gisellegk/ECEN2440-final-project/Code/altimeter_teensy/Flight_Electronics_CPU/Altimeter_out.PNG

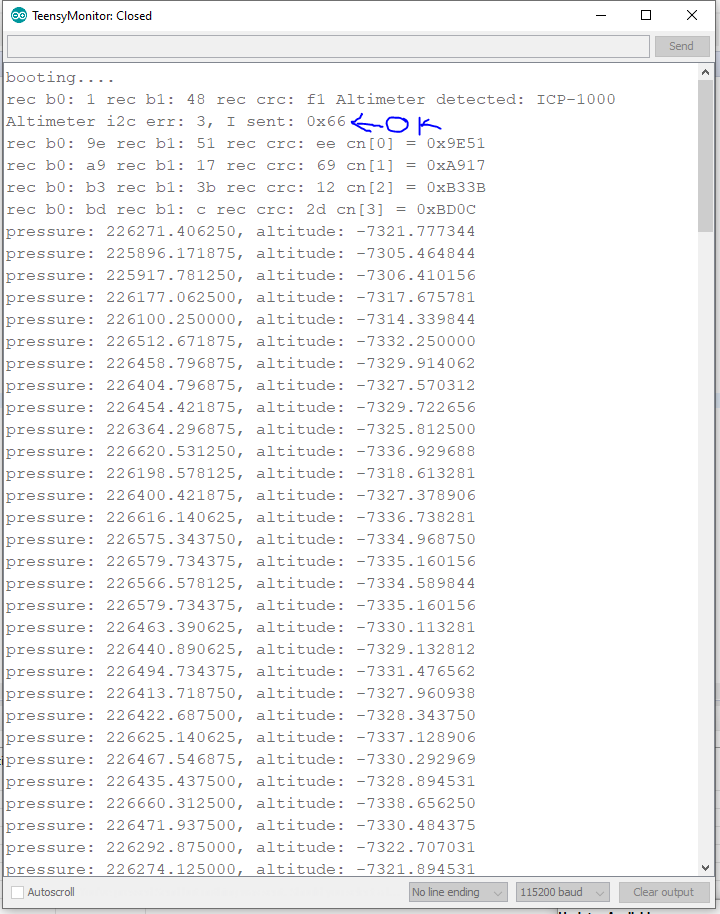
Code/altimeter_teensy/Flight_Electronics_CPU/Altimeter_out.PNG
