gisellegk/ECEN2440-final-project/ltspice/AZ2085/AZ2085 Voltage Range Simulation - 3 cell.PNG

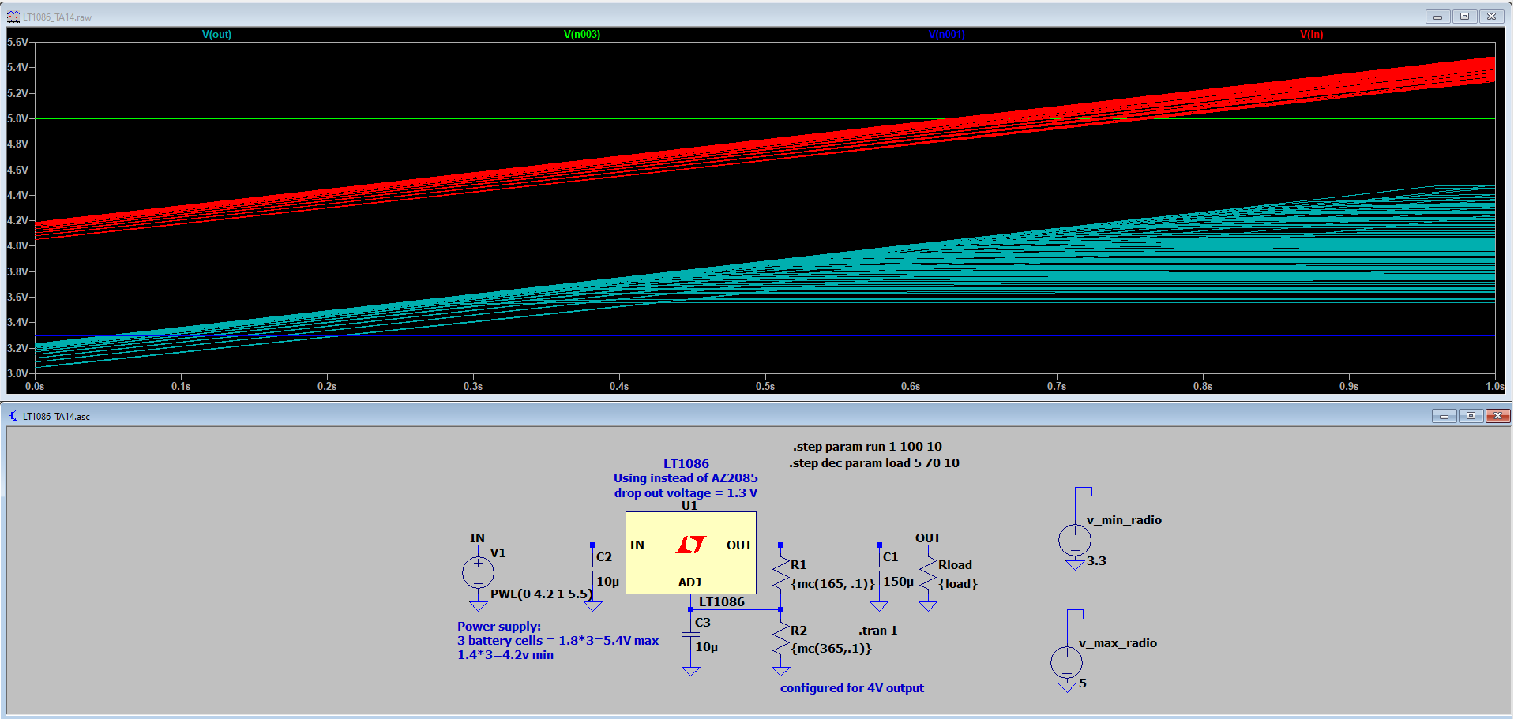
ltspice/AZ2085/AZ2085 Voltage Range Simulation - 3 cell.PNG
