gisellegk/ECEN2440-final-project/ltspice/AZ2085/AZ2085 Voltage Range Simulation - 4 cell.PNG

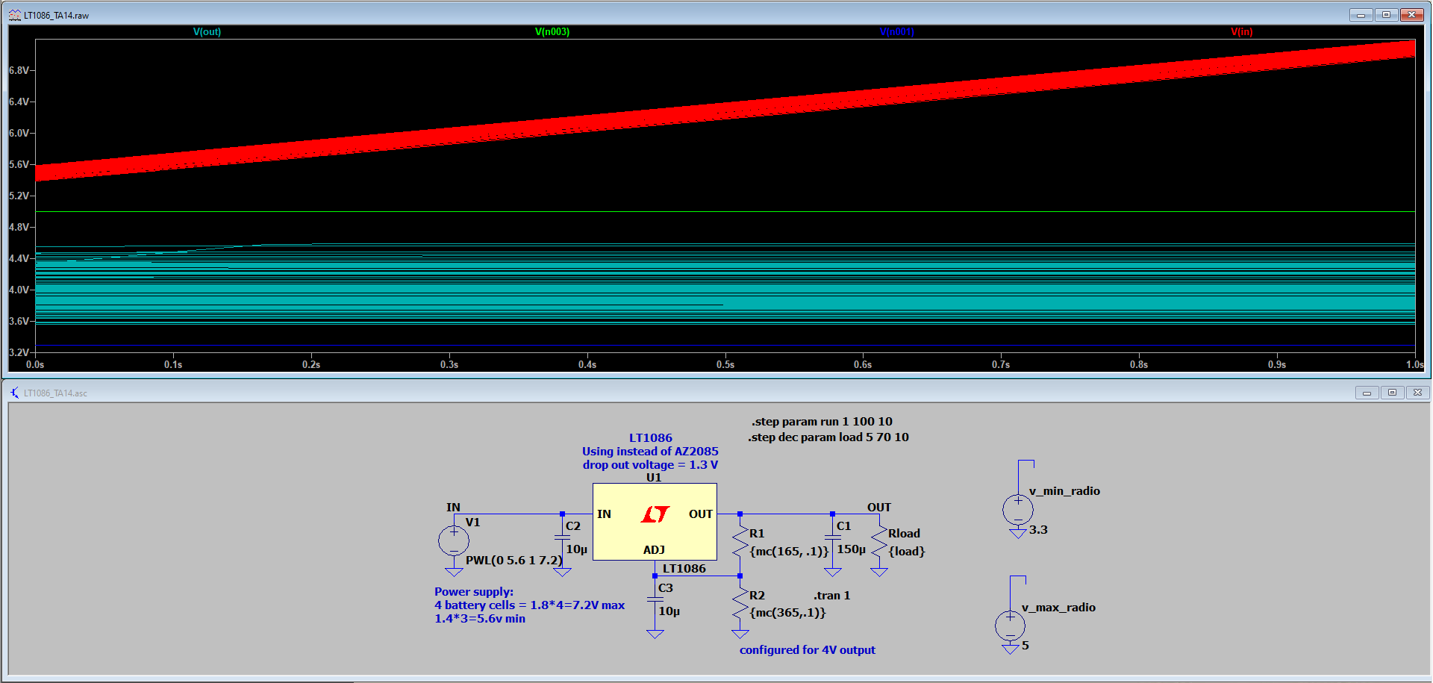
ltspice/AZ2085/AZ2085 Voltage Range Simulation - 4 cell.PNG
