gisellegk/ECEN2440-final-project/ltspice/export graph/FFT_2ord_100kHz.PNG

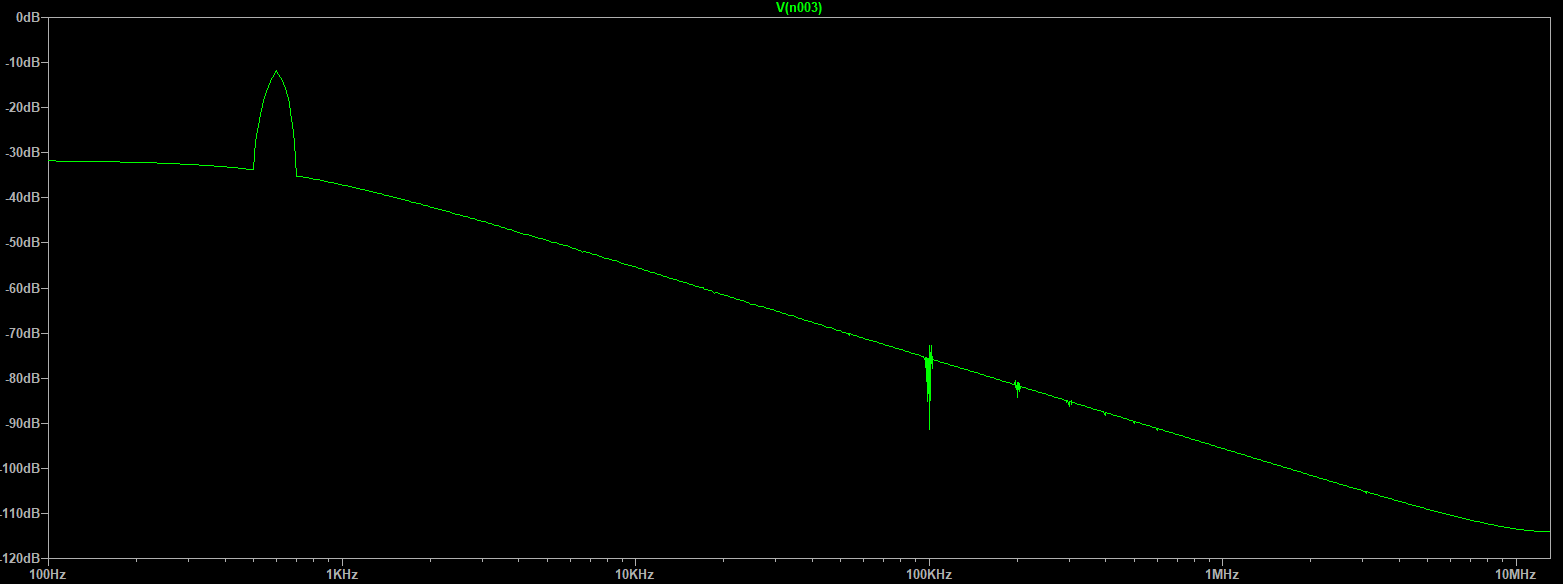
ltspice/export graph/FFT_2ord_100kHz.PNG
