gisellegk/ECEN2440-final-project/ltspice/export graph/FFT_3ord_100k200k_zoom.PNG

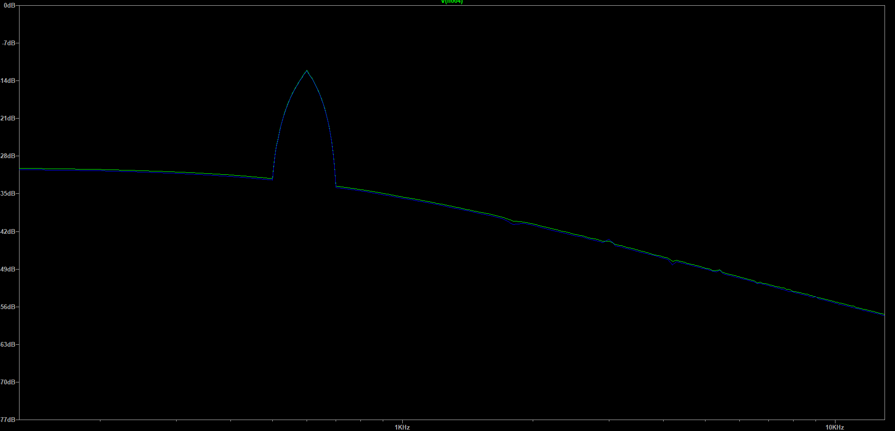
ltspice/export graph/FFT_3ord_100k200k_zoom.PNG
