gisellegk/ECEN2440-final-project/ltspice/export graph/FFT_3ord_300kHz.PNG

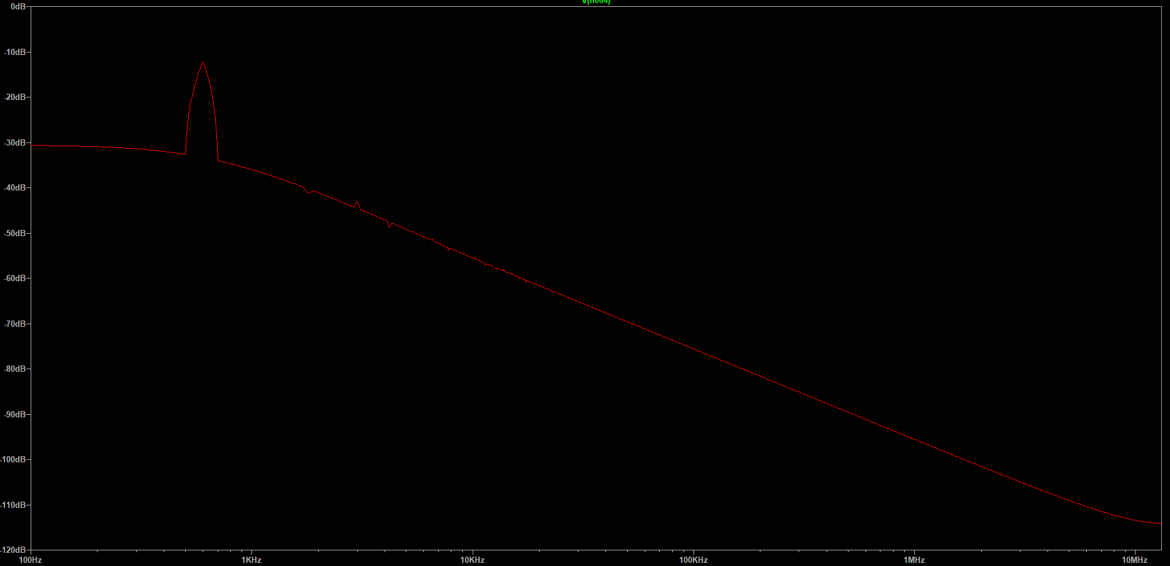
ltspice/export graph/FFT_3ord_300kHz.PNG
