gisellegk/ECEN2440-final-project/ltspice/export graph/SINE_2ord_100k200k300k500k.PNG

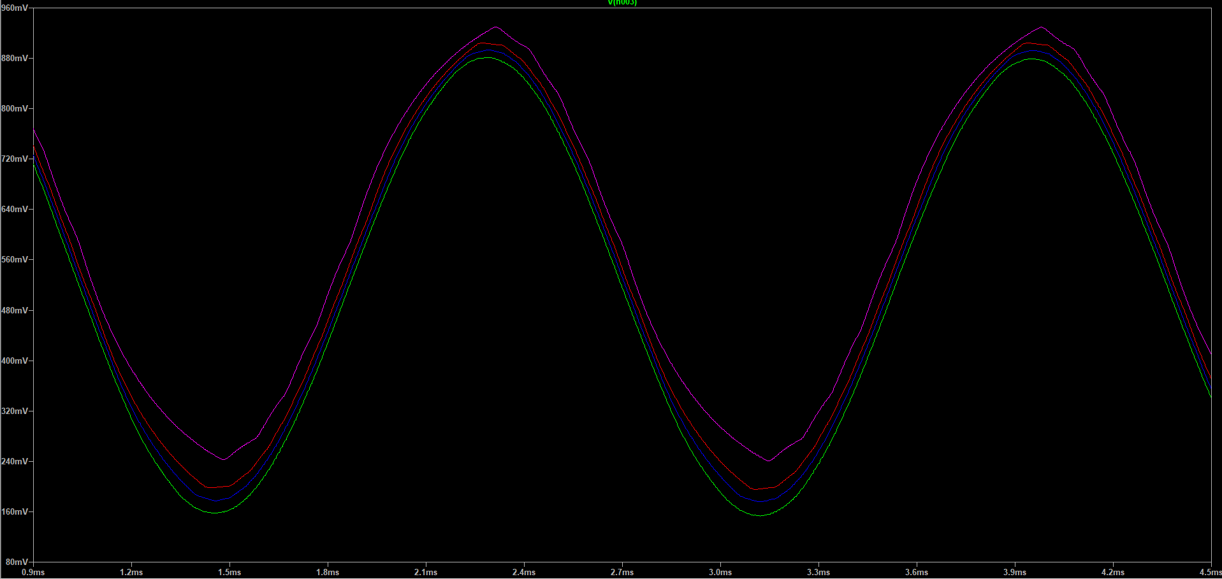
ltspice/export graph/SINE_2ord_100k200k300k500k.PNG
