gisellegk/ECEN2440-final-project/ltspice/LT1963A/LT1963 voltage output simulation.PNG

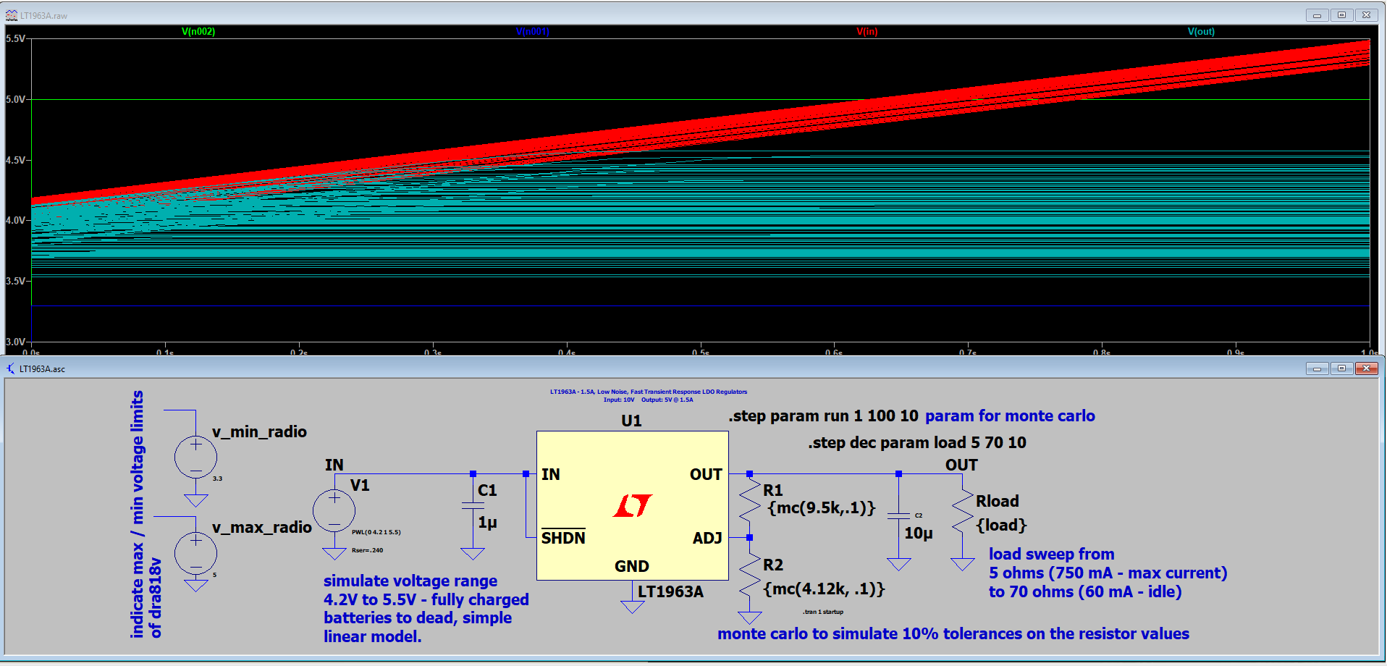
ltspice/LT1963A/LT1963 voltage output simulation.PNG
