gisellegk/ECEN2440-final-project/PCB/Altimeter Board/Bot.png

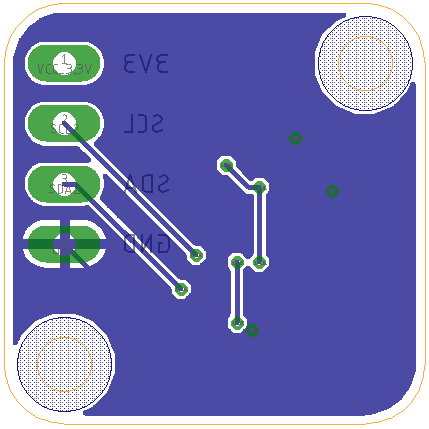
PCB/Altimeter Board/Bot.png
