gisellegk/ECEN2440-final-project/PCB/Altimeter Board/Top.png

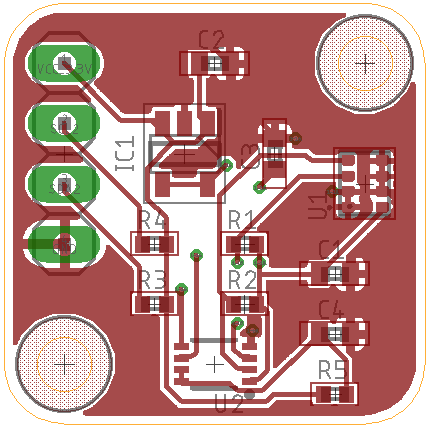
PCB/Altimeter Board/Top.png
