gisellegk/ECEN2440-final-project/PCB/ECEN 2440 Final Project/PDR SCHEMATIC.png

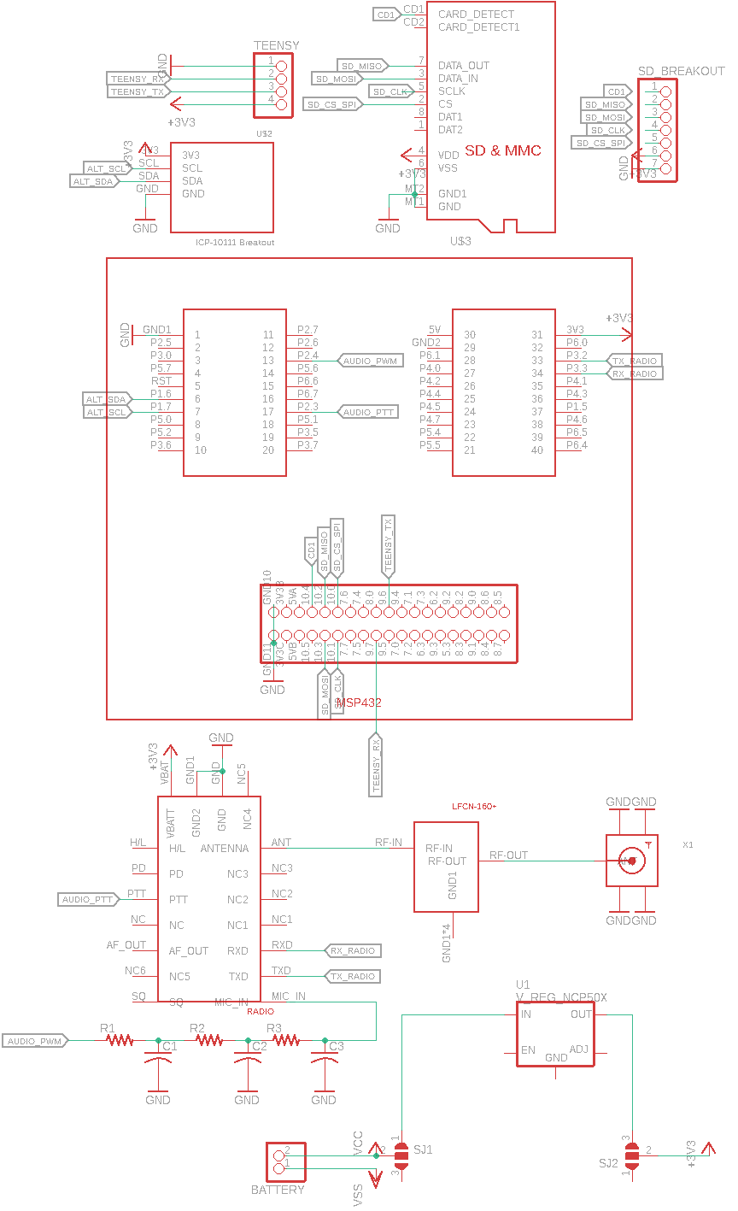
PCB/ECEN 2440 Final Project/PDR SCHEMATIC.png
