gisellegk/ECEN2440-final-project/PCB/ECEN 2440 Final Project/RF_both.PNG

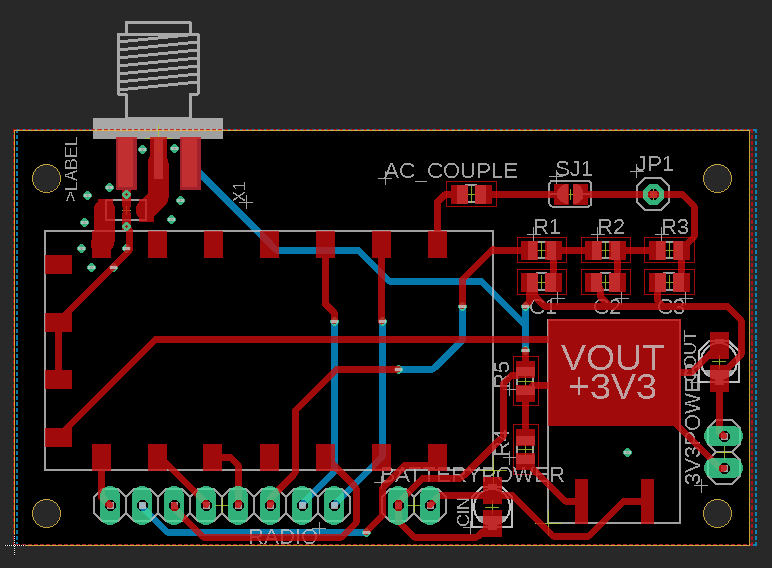
PCB/ECEN 2440 Final Project/RF_both.PNG
