gisellegk/ECEN2440-final-project/PCB/ECEN 2440 Final Project/RF_top.PNG

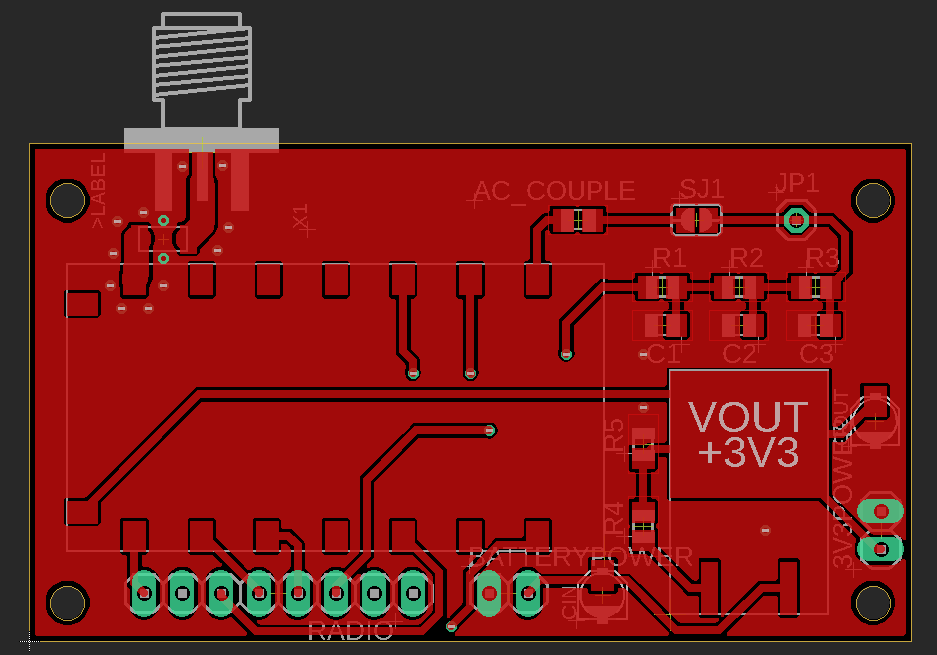
PCB/ECEN 2440 Final Project/RF_top.PNG
