gisellegk/ECEN2440-final-project/PCB/meowth/52-528157_meowth-meow-pokemon.png

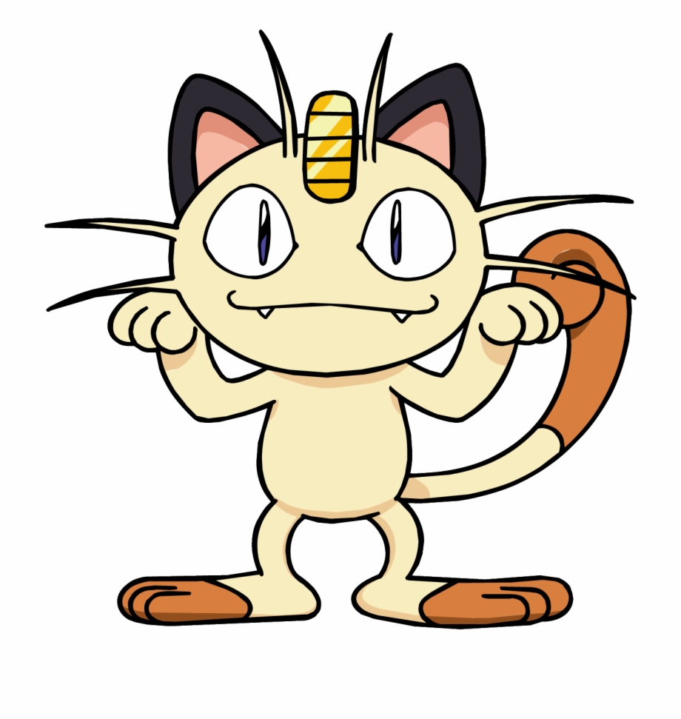
PCB/meowth/52-528157_meowth-meow-pokemon.png
