gisellegk/ECEN2440-final-project/PCB/meowth/meowth/meowth_oshpark_preview.PNG

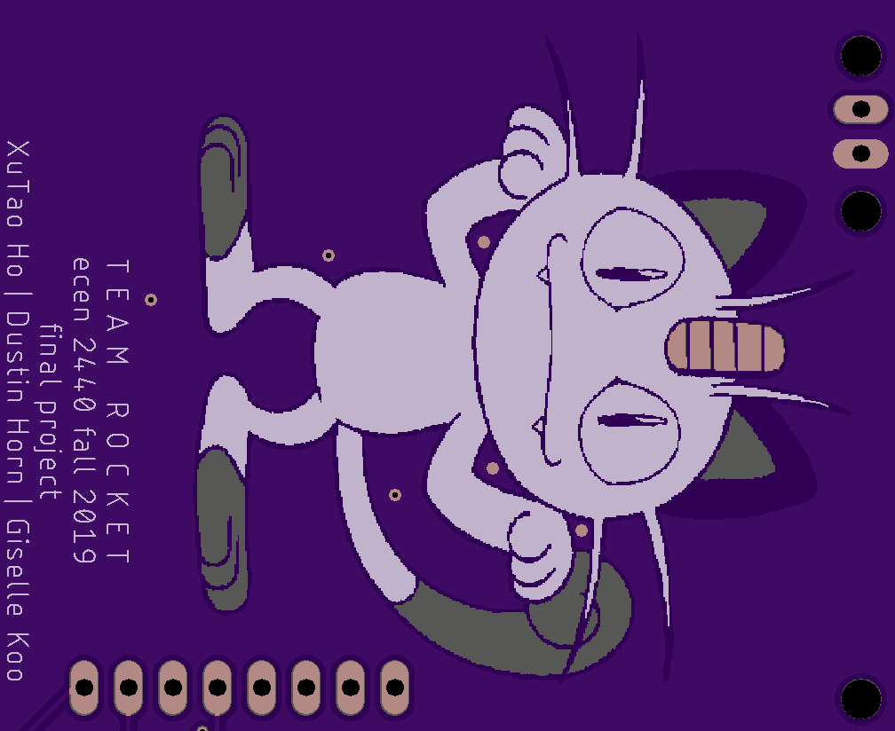
PCB/meowth/meowth/meowth_oshpark_preview.PNG
