gisellegk/ECEN2440-final-project/PCB/meowth/meowth/no_copper.bmp

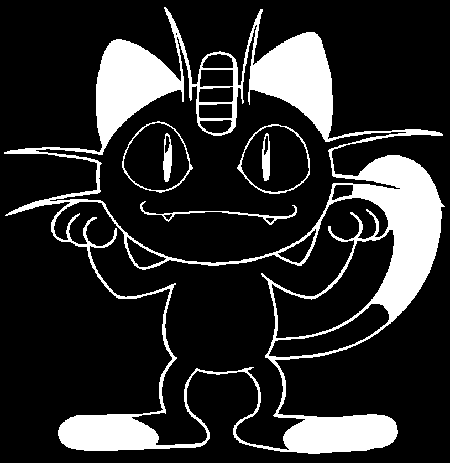
PCB/meowth/meowth/no_copper.bmp
