gisellegk/ECEN2440-final-project/PCB/meowth/meowth/silkscreen.bmp

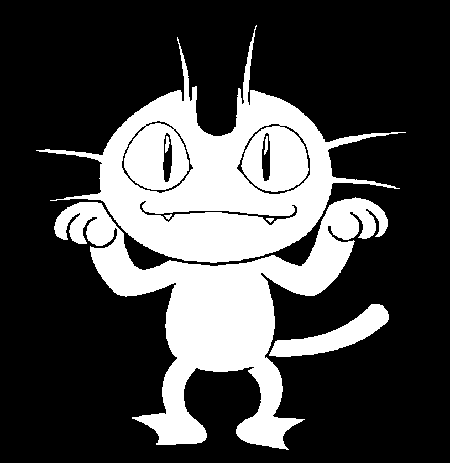
PCB/meowth/meowth/silkscreen.bmp
