gisellegk/ECEN2440-final-project/PCB/meowth/meowth_bold/meowth_bold_bw_copper.bmp

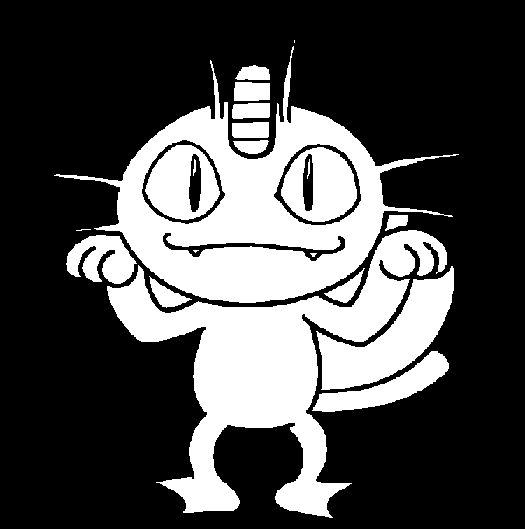
PCB/meowth/meowth_bold/meowth_bold_bw_copper.bmp
