gisellegk/ECEN2440-final-project/PCB/PCBWay Board Quote.PNG

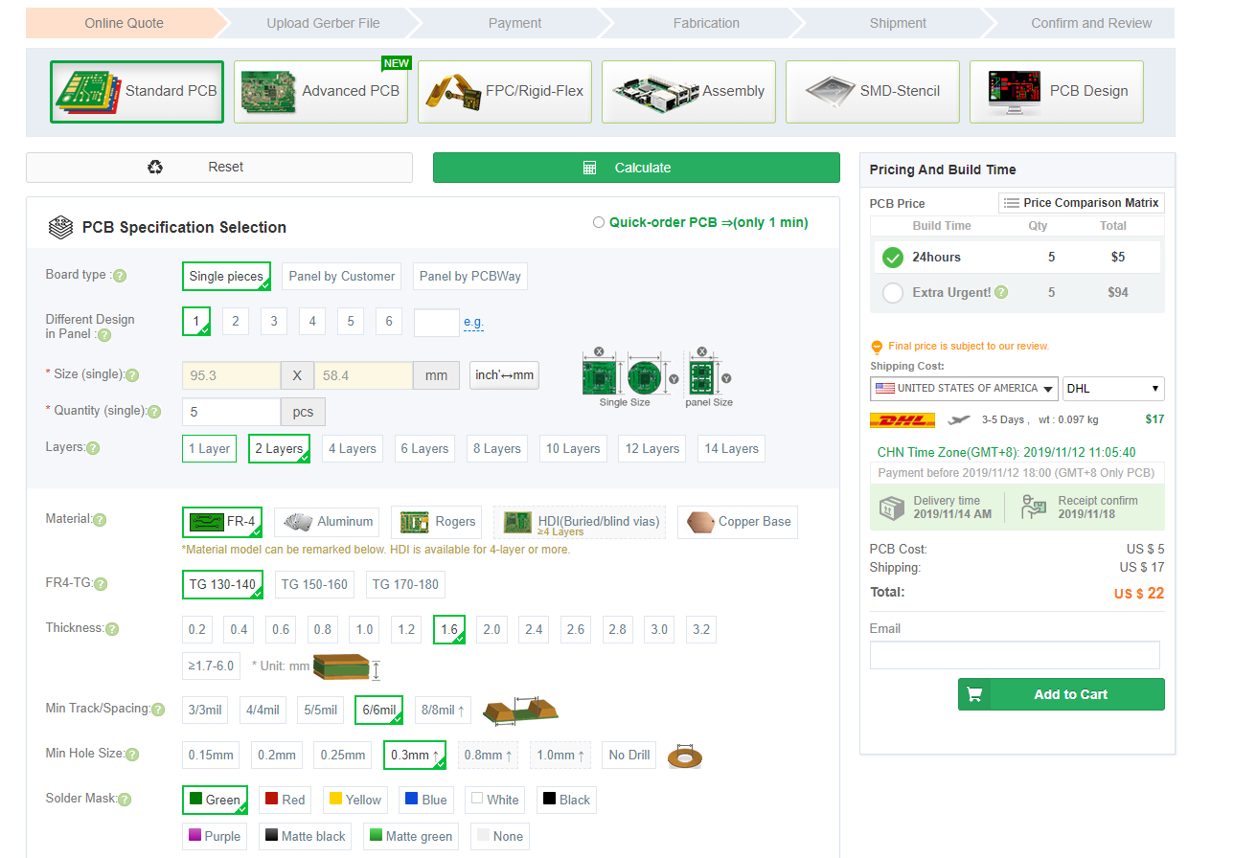
PCB/PCBWay Board Quote.PNG
