gisellegk/ECEN2440-final-project/PCB/wobbuffet/202.png

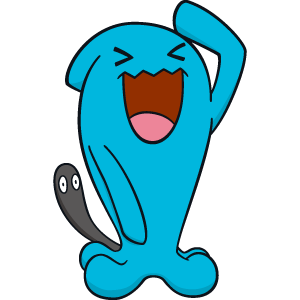
PCB/wobbuffet/202.png
