gisellegk/ECEN2440-final-project/PCB/wobbuffet/wob.bmp

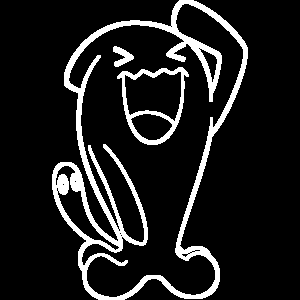
PCB/wobbuffet/wob.bmp
