gisellegk/ECEN2440-final-project/Housing/Prototype assembly.SLDASM

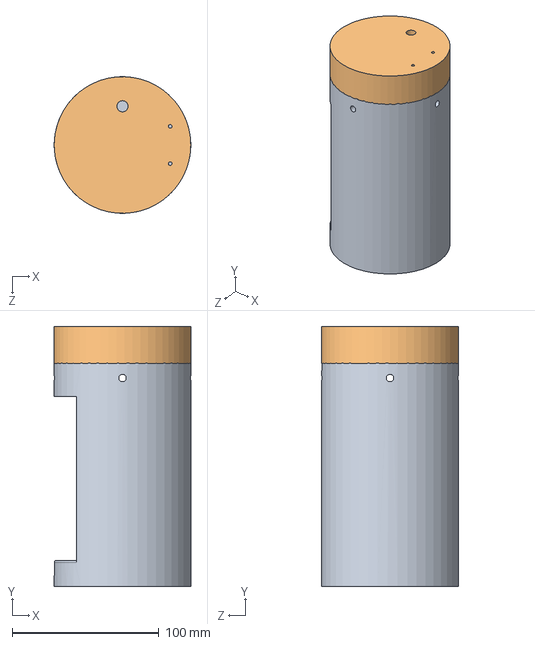
[picture p34: CAD file, 2019-12-04]
Housing/Prototype assembly.SLDASM
93.2 x 177.4 x 93.2 mm
Designed for tube prototype 2
Designed for tube prototype 2b
