gisellegk/ECEN2440-final-project/Housing/Prototype 1 assembly.SLDASM

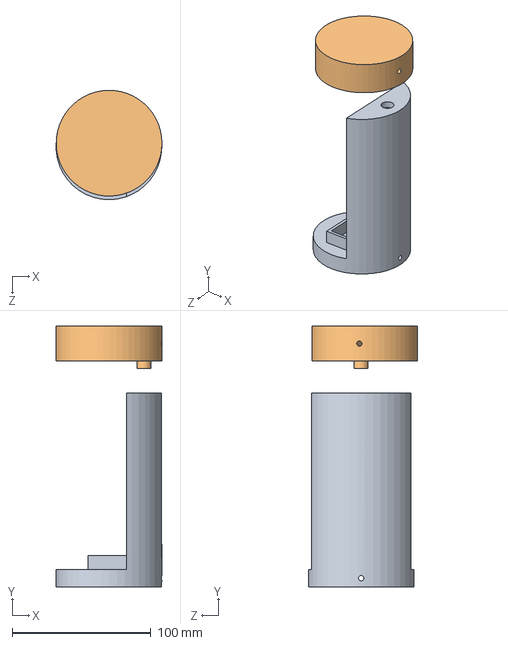
[picture p35: CAD file, 2019-11-29]
Housing/Prototype 1 assembly.SLDASM
76.3 x 188.1 x 78.8 mm
Prototype 1
prototype 1b
