gisellegk/ECEN2440-final-project/Housing/Designed for tube prototype 2b CAP THIS ONE.STL

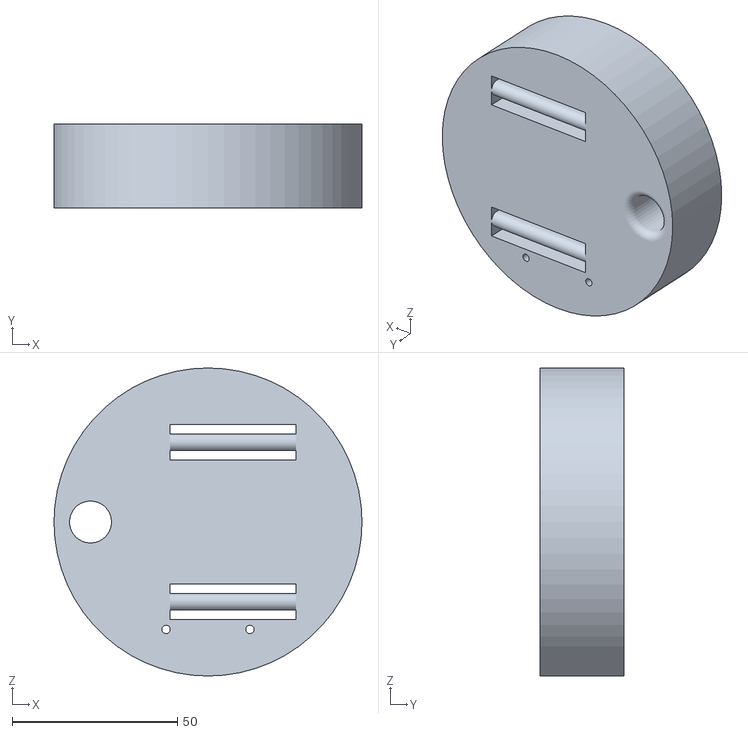
[picture p36: CAD file, 2019-12-07]
Housing/Designed for tube prototype 2b CAP THIS ONE.STL
93.2 x 25.4 x 93.2
