gisellegk/ECEN2440-final-project/Housing/Designed for tube prototype 2b.SLDPRT

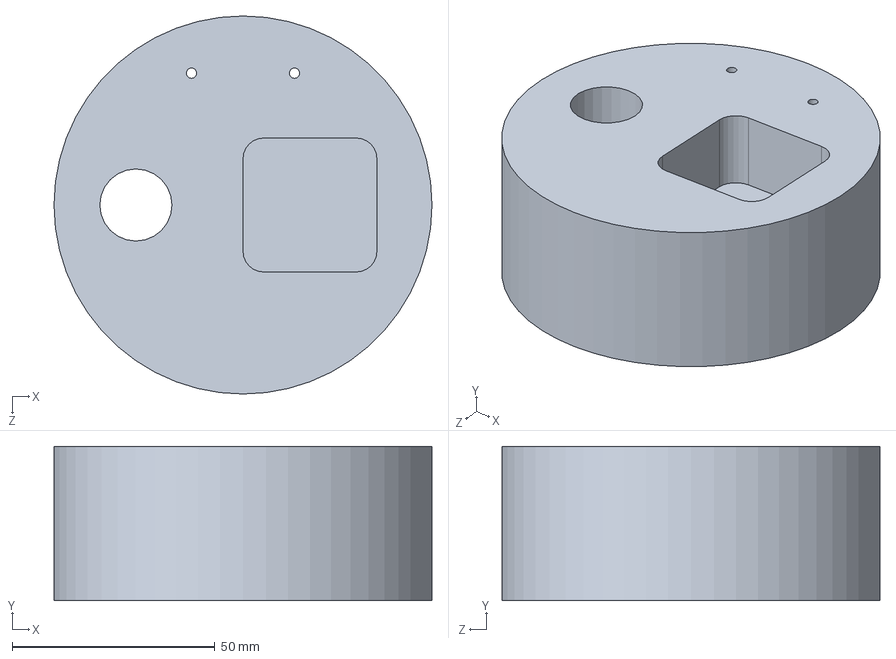
[picture p37: CAD file, 2019-12-06]
Housing/Designed for tube prototype 2b.SLDPRT
93.2 x 38.1 x 93.2 mm
