gisellegk/ECEN2440-final-project/Housing/Designed for tube prototype 2.SLDPRT

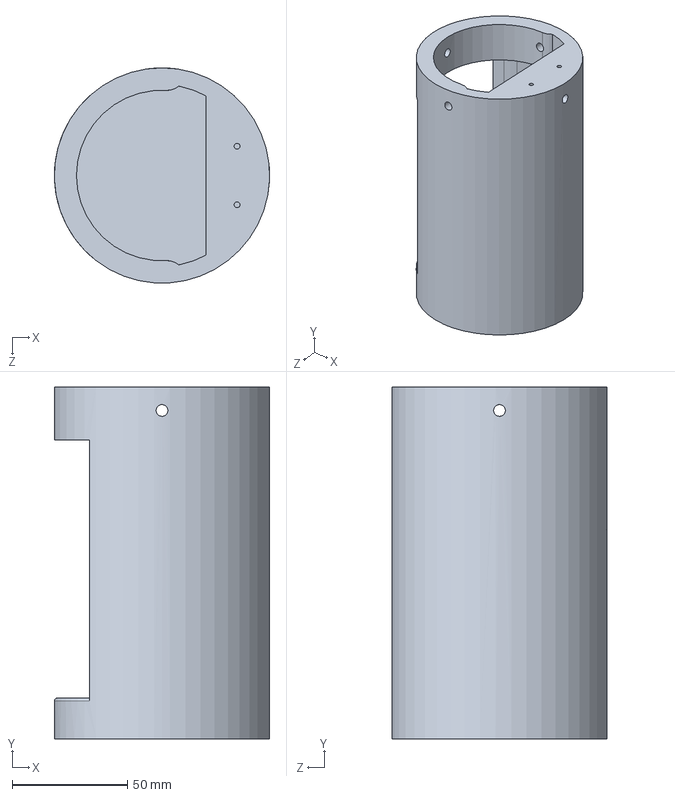
[picture p38: CAD file, 2019-12-05]
Housing/Designed for tube prototype 2.SLDPRT
93.2 x 152.4 x 93.2 mm
