gisellegk/ECEN2440-final-project/Housing/prototype 1b.SLDPRT

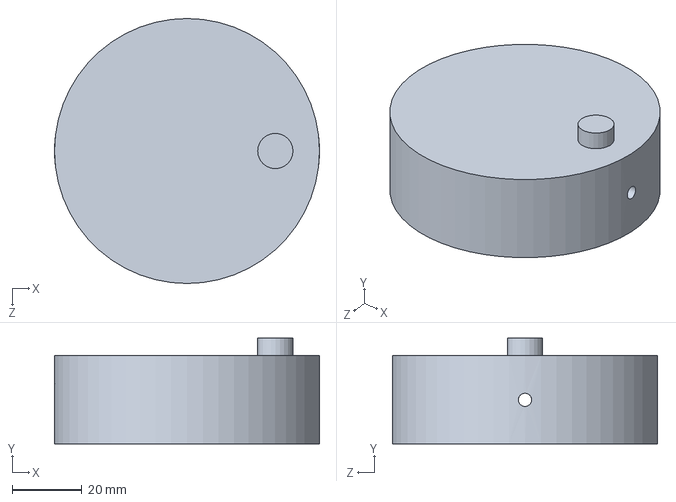
[picture p39: CAD file, 2019-11-29]
Housing/prototype 1b.SLDPRT
76.2 x 30.5 x 76.2 mm
