gisellegk/ECEN2440-final-project/Housing/Prototype 1.SLDPRT

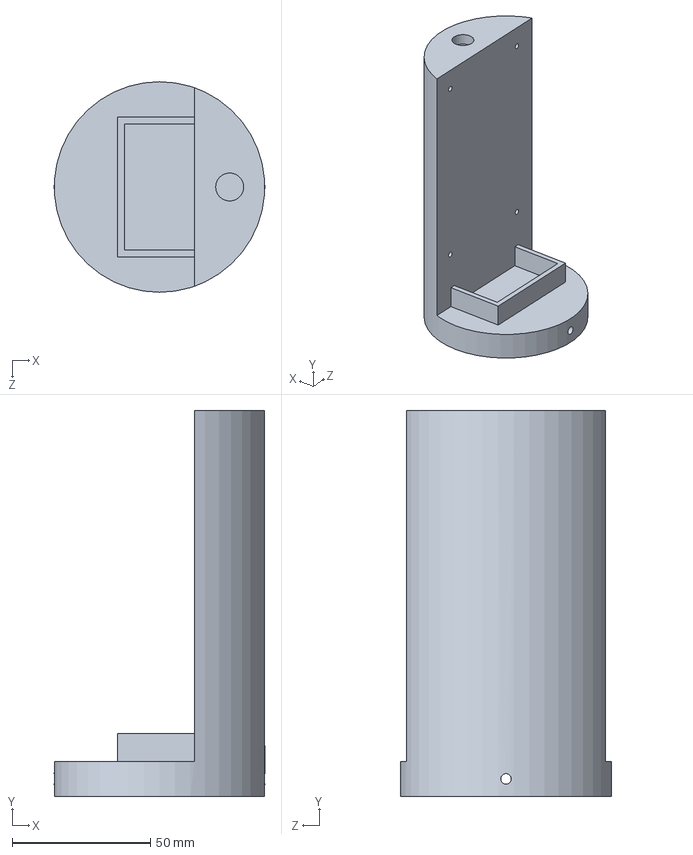
[picture p40: CAD file, 2019-11-29]
Housing/Prototype 1.SLDPRT
76.2 x 139.7 x 76.2 mm
