gisellegk/ECEN2440-final-project/(list of files, cad)

Other CAD files:
Housing/Designed for tube prototype 2.STL
