gisellegk/ECEN2440-final-project/PCB/meowth/meowth/no_soldermask.bmp

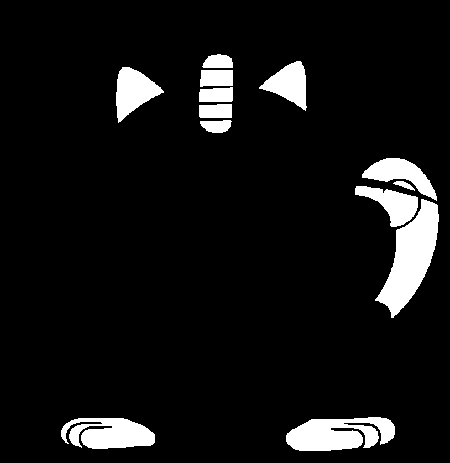
PCB/meowth/meowth/no_soldermask.bmp
