gisellegk/ECEN2440-final-project/pspice/BDxxC0AxFP/BDxxC0AxFP/TestCircuit/BD00C0AWFP-PSpiceFiles/1_CircuitCurrent/1_CircuitCurrent/1_CircuitCurrent.cir

** Profile: "1_CircuitCurrent-1_CircuitCurrent"  [ D:\1_WebUp\kakuninn\BD00C0A\TestCircuit\bd00c0awfp-pspicefiles\1_circuitcurrent\1_circuitcurrent.sim ] 

** Creating circuit file "1_CircuitCurrent.cir" 
** WARNING: THIS AUTOMATICALLY GENERATED FILE MAY BE OVERWRITTEN BY SUBSEQUENT SIMULATIONS

*Libraries: 
* Profile Libraries :
* Local Libraries :
.LIB "../../../bdxxc0axfp.lib" 
* From [PSPICE NETLIST] section of C:\SPB_Data\cdssetup\OrCAD_PSpice\17.2.0\PSpice.ini file:

*Analysis directives: 
.DC LIN V_VCC 0 26.5 0.01 
.OPTIONS ADVCONV
.PROBE64 V(alias(*)) I(alias(*)) W(alias(*)) D(alias(*)) NOISE(alias(*)) 
.INC "..\1_CircuitCurrent.net" 


.END
