gisellegk/ECEN2440-final-project/ltspice/LM317/Draft2.asc

C1: cap; {mc(2.2µ,.2)}; Rser={mc(100m,1)}
C4: cap; {mc(100n,.2)}; Rser={mc(100m,1)}
C5: cap; {mc(2.2µ,.2)}; Rser={mc(100m,1)}
COUT: cap; {mc(10µ,.2)}; Rser={mc(21,1)}
L1: ind; {mc(1.59µ, .3)}; Ipk=2 Rser={mc(100m,1)}
R1: res; {mc(2,.1)}
R8: res; {mc(2,.1)}
V1: voltage; SINE(4 1 144kHz); AC 1; Rser={mc(100m,1)}
Named nets: 0
.ac dec 100 1k 432Meg
mc on ESR of L:
mc(100m, 1)
mc on ESR of COUT:
mc(21, 1)
mc on ESR of C5:
mc(100m, 1)
mc on ESR of C4:
mc(100m, 1)
.step param run 1 100 1
