gisellegk/ECEN2440-final-project/ltspice/LM317/Draft1.asc

R1: res; {mc(120,.1)}
R2: res; {mc(240,.1)}
R3: res; {LOAD}
U1: LM317
V1: voltage; 5; Rser=240m
v_max_radio1: voltage; 5
v_min_radio1: voltage; 3.3
Named nets: 0, Vin, Vout
.dc V1 4.2 5.4 .01
.step param run 1 100 10
.step dec param LOAD 5 70 2
indicate max / min voltage limits
of dra818v
