gisellegk/ECEN2440-final-project/ltspice/AZ2085/LT1086_TA14.asc

C1: cap; 150µ
C2: cap; 10µ
C3: cap; 10µ
R1: RES; {mc(165, .1)}
R2: RES; {mc(365,.1)}
Rload: RES; {load}
U1: LT1086
V1: VOLTAGE; PWL(0 4.2 1 5.5); Rser=0.240
v_max_radio: VOLTAGE; 5; Rser=0.1
v_min_radio: VOLTAGE; 3.3; Rser=0.1
Named nets: OUT, 0, IN
.tran 1
LT1086
Using instead of AZ2085
drop out voltage = 1.3 V
configured for 4V output
Power supply: 
3 battery cells = 1.8*3=5.4V max
1.4*3=4.2v min
.step dec param load 5 70 10
.step param run 1 100 10
