gisellegk/ECEN2440-final-project/ltspice/LT1963A/LT1963A.asc

C1: cap; 1µ
C2: cap; 10µ
R1: res; {mc(9.5k,.1)}
R2: res; {mc(4.12k, .1)}
Rload: res; {load}
U1: LT1963A
V1: voltage; PWL(0 4.2 1 5.5); Rser=.240
v_max_radio: voltage; 5
v_min_radio: voltage; 3.3
Named nets: 0, OUT, IN
.tran 1 startup
LT1963A - 1.5A, Low Noise, Fast Transient Response LDO Regulators
Input: 10V     Output: 5V @ 1.5A
.step param run 1 100 10
.step dec param load 5 70 10
monte carlo to simulate 10% tolerances on the resistor values
load sweep from 
5 ohms (750 mA - max current) 
to 70 ohms (60 mA - idle)
simulate voltage range 
4.2V to 5.5V - fully charged 
batteries to dead, simple
linear model.
indicate max / min voltage limits
of dra818v
param for monte carlo
