gisellegk/ECEN2440-final-project/ltspice/PWM and Filtering/Draft2.asc

B1: bv; V=(V(TA_R)<=V(sine_LUT))
B2: bv; V=(idtmod(1,0,1/f_pwm)*Fsys)
B3: bv; V=(floor(V(Timer_Raw)))
B4: bv; V=floor(CR0*V(audio_sine))
C1: cap; {C}
C2: cap; {C}
C3: cap; {C}
R1: res; {R}
R2: res; {R}
R3: res; {R}
V2: voltage; SINE(.5 .5 600 0)
Named nets: 0, audio_sine, Timer_RAW, TA_R, sine_LUT
.step param f_pwm 100k 500k 100k
.tran 0 10m 0 10n
.param C 500n
.param R 100
.param Fsys 3e6
.param CR0 {Fsys/f_pwm}
600Hz desired audio 
voltage %, from 0 to 1
multiplying sine voltage % by 
CR0 (which is # of ticks 
per PWM cycle, zero 
indexed) = number of 
ticks long your PWM 
pulse should be
TA_R tells you what tick you're on 
so if this value is true then the signal will be 1, 
and if it's false, the signal will be 0
discrete values of TA_R (x axis)
discrete voltage levels of sine wave (y axis)
