gisellegk/ECEN2440-final-project/(list of files, drawings)

Other design files:
pspice/BD00C0AW_PSpice/BD00C0AW.OLB
pspice/BD33C0AW_PSpice/BD33C0AW.OLB
pspice/BDxxC0AxFP/BDxxC0AxFP/BDxxC0AxFP.OLB
pspice/BDxxC0AxFP/BDxxC0AxFP/bdxxc0axfp.opj
pspice/BDxxC0AxFP/BDxxC0AxFP/TestCircuit/BD00C0AWFP.DSN
pspice/BDxxC0AxFP/BDxxC0AxFP/TestCircuit/BD00C0AWFP.opj
pspice/BDxxC0AxFP/BDxxC0AxFP/TestCircuit/olb/BDxxC0AxFP.OLB
pspice/ncp1117/NCP1117 MODEL LIBRARY.OLB
pspice/ncp1117/NCP1117 MODEL LIBRARY.OPJ
