gisellegk/ECEN2440-final-project/PCB/ECEN 2440 Final Project/Custom Sheild-PCB.brd

## EAGLE design PCB/ECEN 2440 Final Project/Custom Sheild-PCB.brd (2019-12-03)

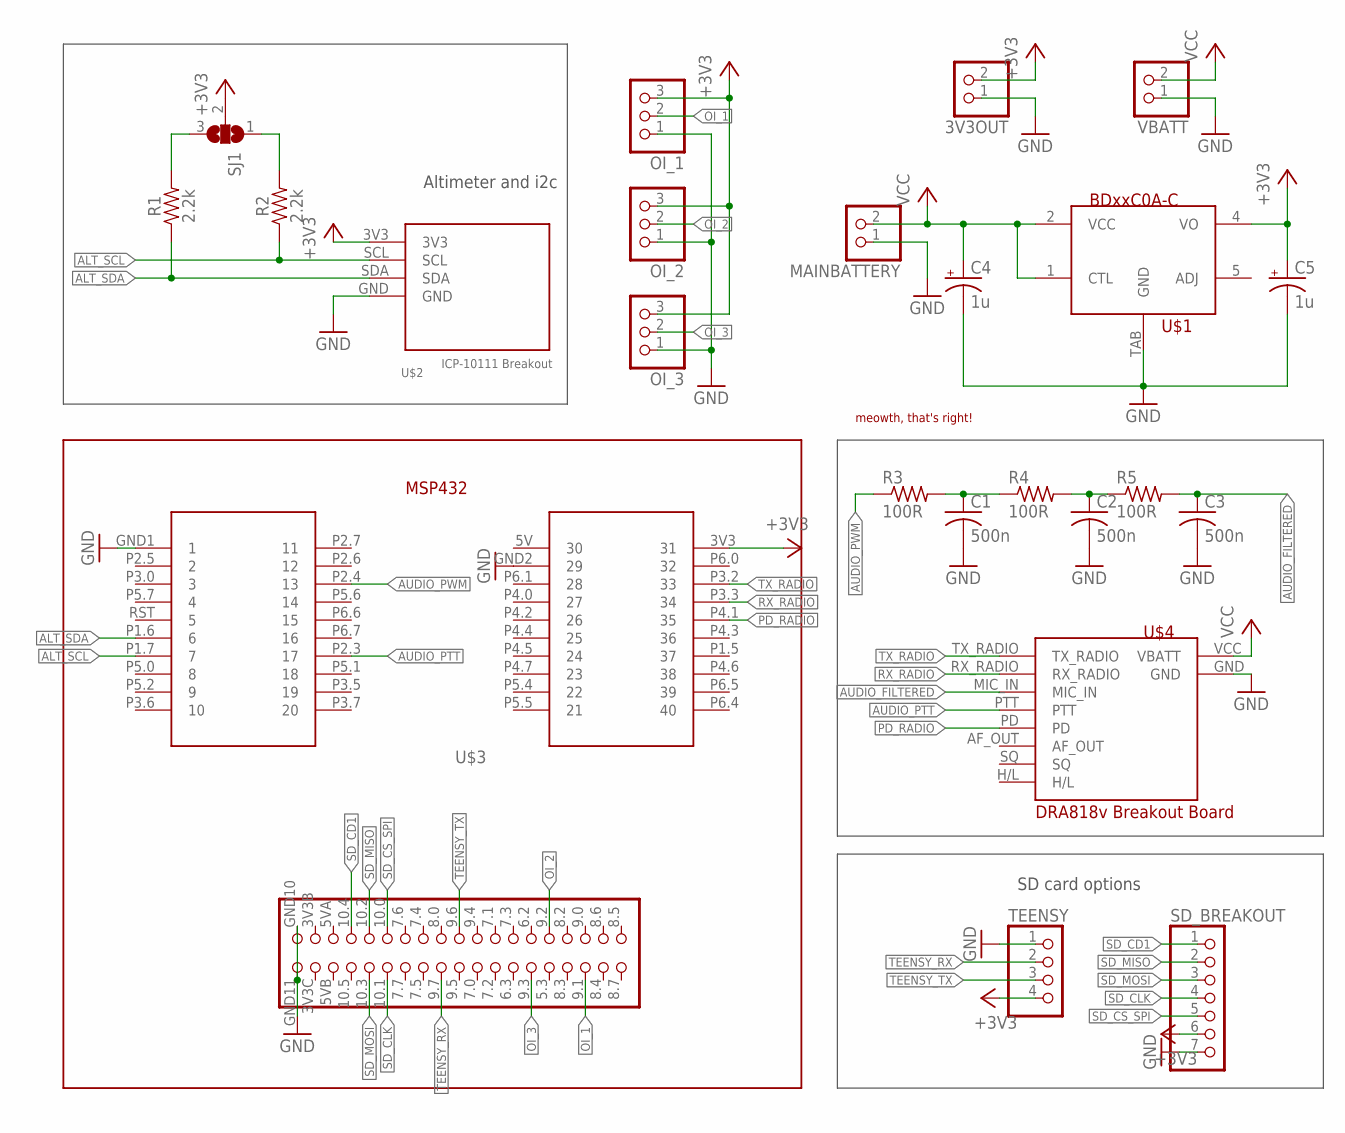
[picture p42: schematic Custom Sheild-PCB.sch]

Parts:
3V3OUT: PINHD-1X2; 1X02
C1, C2, C3: 500n; C0805
C4, C5: 1u; PANASONIC_A
MAINBATTERY: PINHD-1X2; 1X02
OI_1, OI_2, OI_3: PINHD-1X3; 1X03
R1, R2: 2.2k; 0603
R3, R4, R5: 100R; R0805
SD_BREAKOUT: PINHD-1X7; 1X07
SJ1: SJ2W; SJ_2
TEENSY: PINHD-1X4; 1X04
U$1: BDXXC0A-CBD33C0AWFP-CE2; TO252-5-11
U$2: ALTIMETER
U$3: MSP432
U$4: DRA_BREAKOUT
U$5: MEOWTH
VBATT: PINHD-1X2; 1X02

Connections:
30: U$3.5V (30)
+3V3: 3V3OUT.2, C5.+, OI_1.3, OI_2.3, OI_3.3, SD_BREAKOUT.6, SJ1.2, TEENSY.4, U$1.4 (VO), U$2.3V3, U$3.3V3 (31)
ALT_SCL: R2.1, U$2.SCL, U$3.P1.7 (7)
ALT_SDA: R1.1, U$2.SDA, U$3.P1.6 (6)
AUDIO_FILTERED: C3.1, R5.2, U$4.MIC_IN
AUDIO_PTT: U$3.P2.3 (17), U$4.PTT
AUDIO_PWM: R3.1, U$3.P2.4 (13)
GND: 3V3OUT.1, C1.2, C2.2, C3.2, C4.-, C5.-, MAINBATTERY.1, OI_1.1, OI_2.1, OI_3.1, SD_BREAKOUT.7, TEENSY.1, U$1.TAB (GND), U$2.GND, U$3.GND1 (1), U$3.GND2 (29), U$3.GND10 (42), U$3.GND11 (41), U$4.GND, VBATT.1
unnamed: R1.2, SJ1.3
unnamed: R2.2, SJ1.1
unnamed: C1.1, R3.2, R4.1
unnamed: C2.1, R4.2, R5.1
OI_1: OI_1.2, U$3.9.1 (73)
OI_2: OI_2.2, U$3.9.2 (70)
OI_3: OI_3.2, U$3.9.3 (67)
PD_RADIO: U$3.P4.1 (35), U$4.PD
RX_RADIO: U$3.P3.3 (34), U$4.RX_RADIO
SD_CD1: SD_BREAKOUT.1, U$3.10.4 (48)
SD_CLK: SD_BREAKOUT.4, U$3.10.1 (51)
SD_CS_SPI: SD_BREAKOUT.5, U$3.10.0 (52)
SD_MISO: SD_BREAKOUT.2, U$3.10.2 (50)
SD_MOSI: SD_BREAKOUT.3, U$3.10.3 (49)
TEENSY_RX: TEENSY.2, U$3.9.7 (57)
TEENSY_TX: TEENSY.3, U$3.9.6 (60)
TX_RADIO: U$3.P3.2 (33), U$4.TX_RADIO
VCC: C4.+, MAINBATTERY.2, U$1.1 (CTL), U$1.2 (VCC), U$4.VCC (VBATT), VBATT.2

Notes on the sheet:
Altimeter and i2c
SD card options

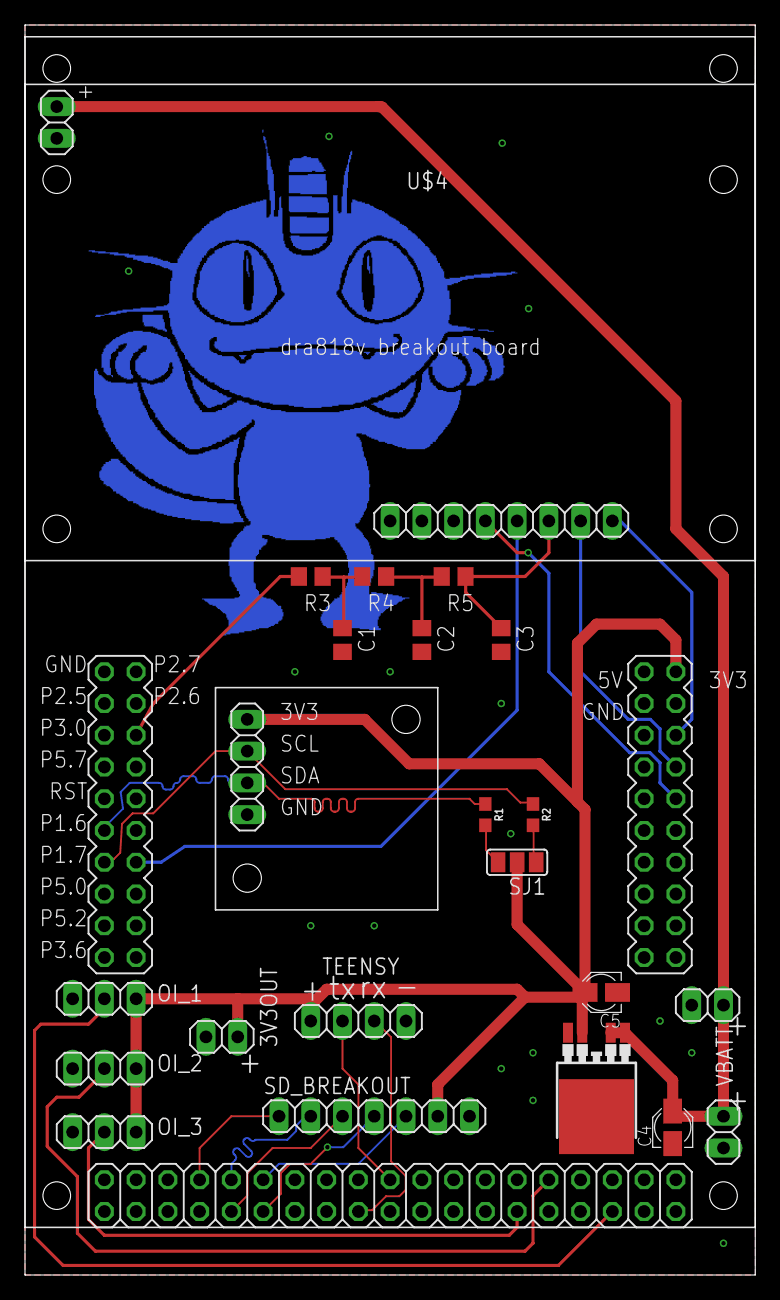
[picture p43: board Custom Sheild-PCB.brd from above]

Board: 2 copper layers, 58.4 x 100.0 mm, 24 parts (1 on the bottom side), 25 nets.
