gisellegk/ECEN2440-final-project/PCB/ECEN 2440 Final Project/Radio Board.brd

## EAGLE design PCB/ECEN 2440 Final Project/Radio Board.brd (2019-12-01)

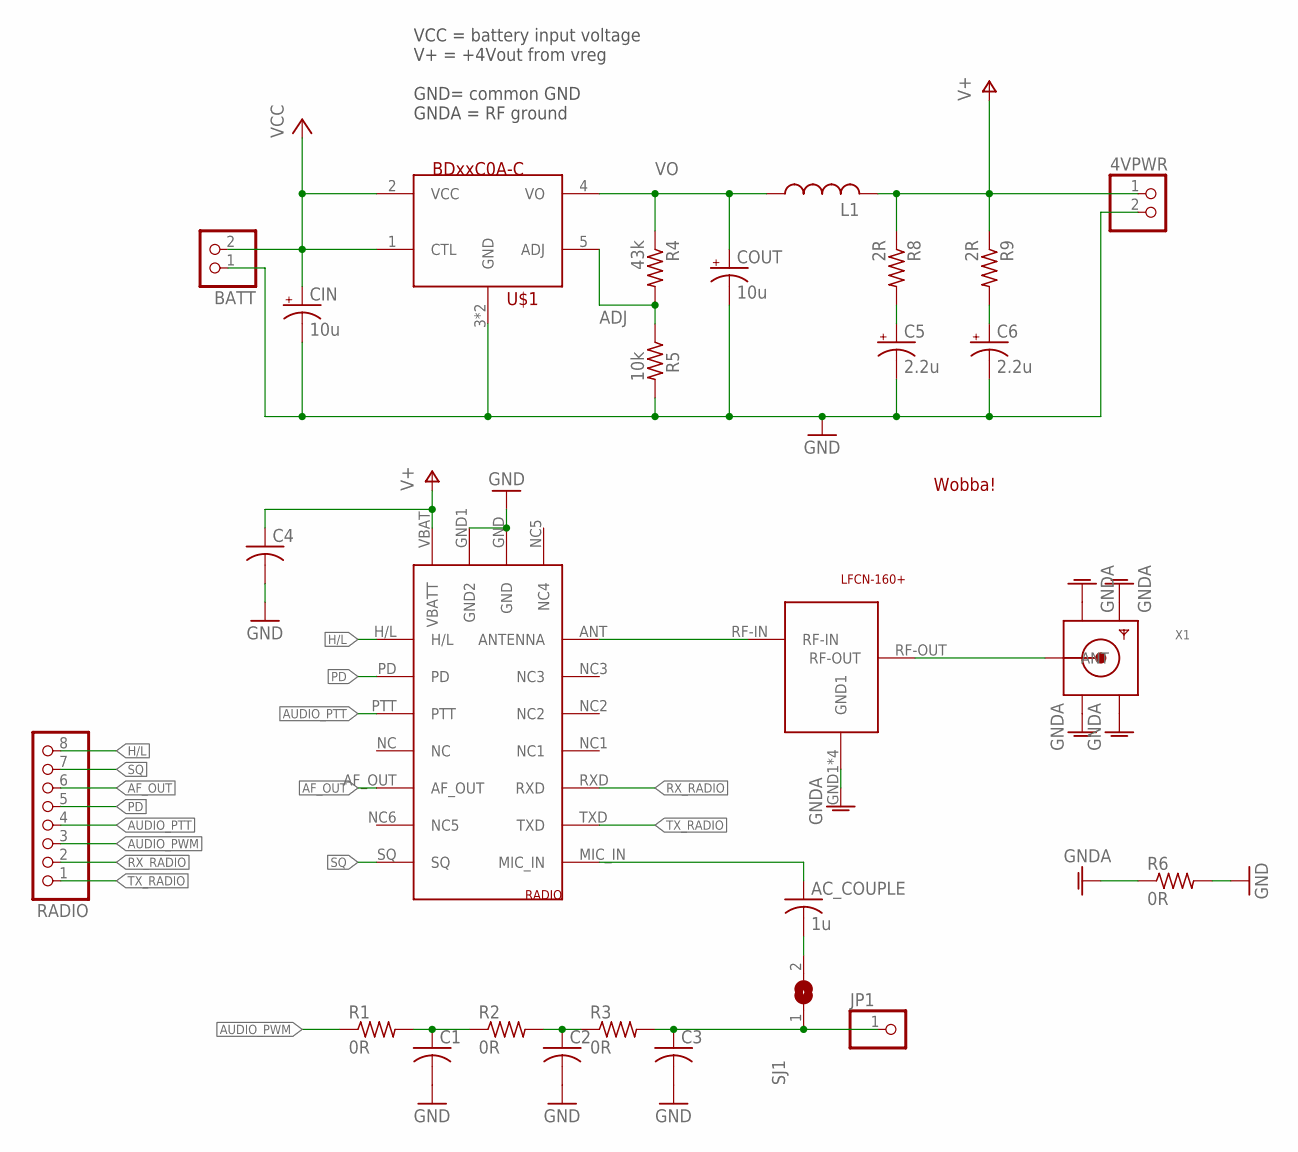
[picture p44: schematic Radio Board.sch]

Parts:
4VPWR: PINHD-1X2; 1X02
AC_COUPLE: 1u; C0805
BATT: PINHD-1X2; 1X02
C1, C2, C3: C-USC0805; C0805
C4: 100n; C0805
C5, C6: 2.2u; PANASONIC_A
CIN: 10u; PANASONIC_A
COUT: 10u; PANASONIC_A
JP1: PINHD-1X1; 1X01
L1: L-USL3225M; L3225M
R1, R2, R3, R6: 0R; R0805
R4: 43k; R0805
R5: 10k; R0805
R8, R9: 2R; R0805
RADIO: PINHD-1X8; 1X08
SJ1: SJ
U$1: BDXXC0A-CBD00C0AWHFP-CTR; HRP5
U$2: WOBBUFFET
U$4: RADIO
U$6: LFCN-160+
X1: SMACONNECTOR_EDGE; SMA_EDGELAUNCH

Connections:
ADJ: R4.2, R5.1, U$1.5 (ADJ)
AF_OUT: RADIO.6, U$4.AF_OUT
AUDIO_PTT: RADIO.4, U$4.PTT
AUDIO_PWM: R1.1, RADIO.3
GND: 4VPWR.2, BATT.1, C1.2, C2.2, C3.2, C4.2, C5.-, C6.-, CIN.-, COUT.-, R5.2, R6.2, U$1.3 (GND), U$1.6 (GND), U$4.GND, U$4.GND1 (GND2)
GNDA: R6.1, U$6.GND1, U$6.GND2 (GND1), U$6.P$1 (GND1), U$6.P$2 (GND1), X1.GND@1 (GND4), X1.GND@2 (GND3), X1.GND@3 (GND2), X1.GND@4 (GND1)
H/L: RADIO.8, U$4.H/L
unnamed: U$4.ANT (ANTENNA), U$6.RF-IN
unnamed: C1.1, R1.2, R2.1
unnamed: C3.1, JP1.1, R3.2, SJ1.1
unnamed: C2.1, R2.2, R3.1
unnamed: AC_COUPLE.1, U$4.MIC_IN
unnamed: U$6.RF-OUT, X1.P (ANT)
unnamed: AC_COUPLE.2, SJ1.2
unnamed: C6.+, R9.2
unnamed: C5.+, R8.2
PD: RADIO.5, U$4.PD
RX_RADIO: RADIO.2, U$4.RXD
SQ: RADIO.7, U$4.SQ
TX_RADIO: RADIO.1, U$4.TXD
V+: 4VPWR.1, C4.1, L1.2, R8.1, R9.1, U$4.VBAT (VBATT)
VCC: BATT.2, CIN.+, U$1.1 (CTL), U$1.2 (VCC)
VO: COUT.+, L1.1, R4.1, U$1.4 (VO)

Notes on the sheet:
VCC = battery input voltage V+ = +4Vout from vreg GND= common GND GNDA = RF ground

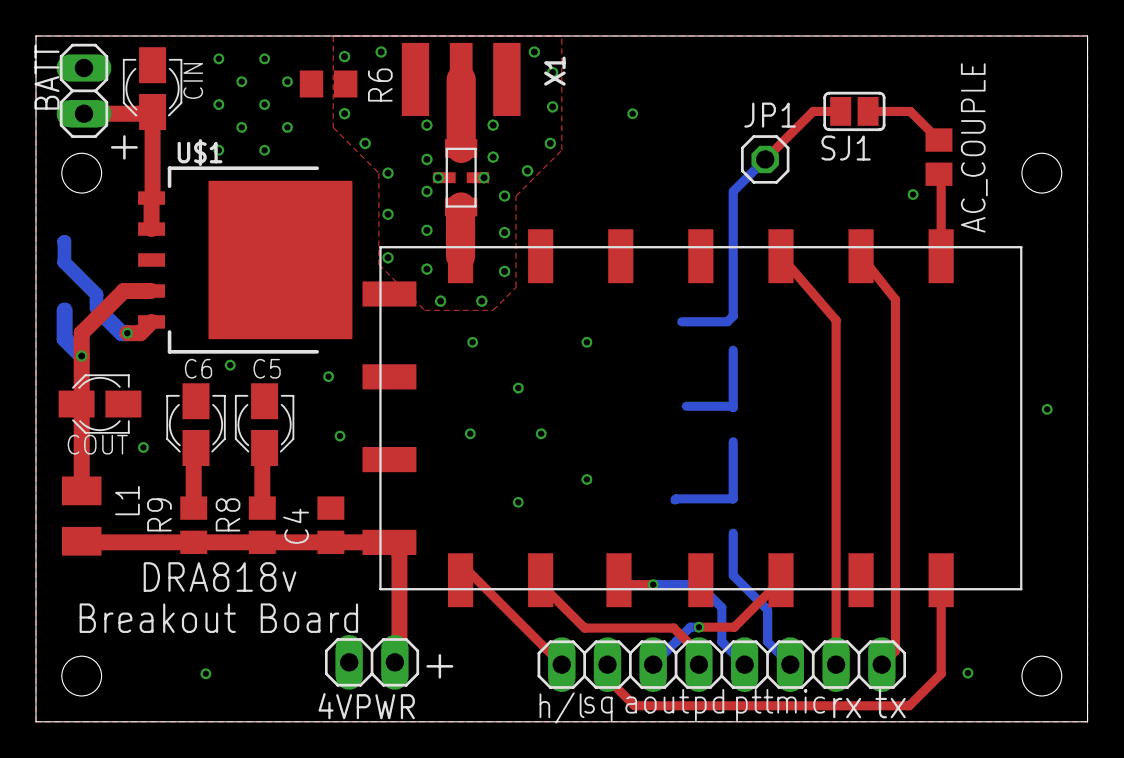
[picture p45: board Radio Board.brd from above]

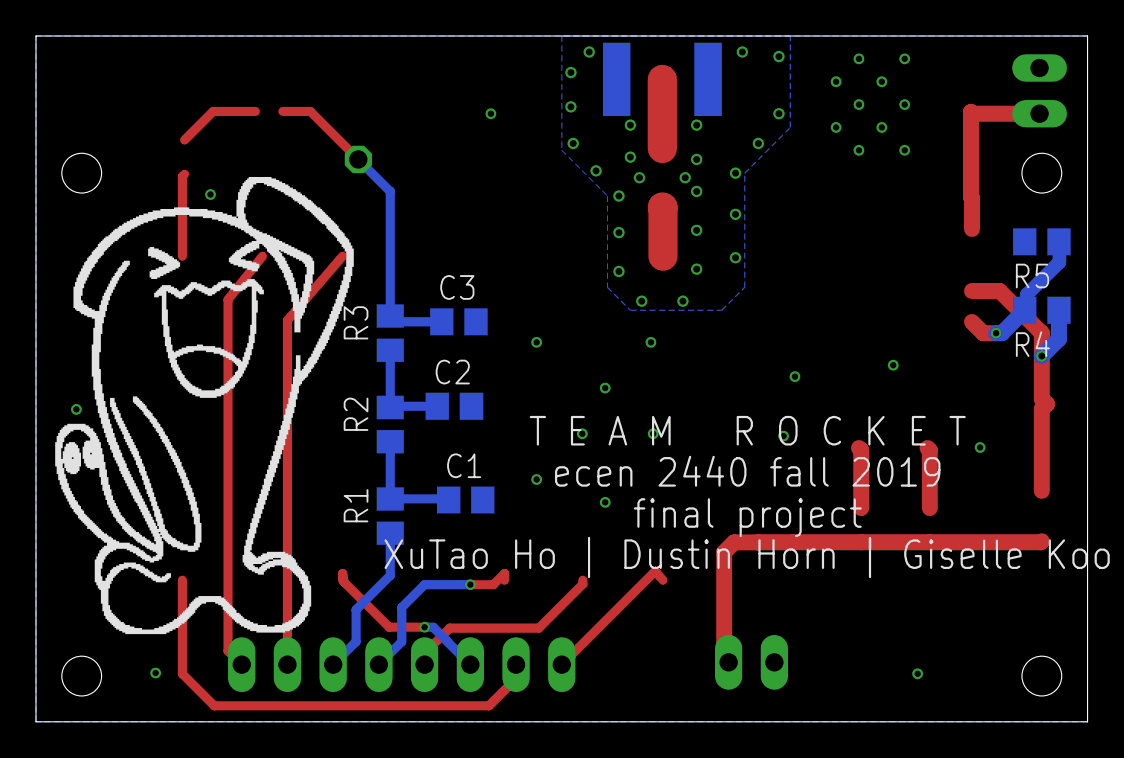
[picture p46: board Radio Board.brd from below]

Board: 2 copper layers, 58.4 x 38.1 mm, 28 parts (9 on the bottom side), 23 nets.
