gisellegk/ECEN2440-final-project/PCB/Altimeter Board/altimeter.brd

## EAGLE design PCB/Altimeter Board/altimeter.brd (2019-11-17)

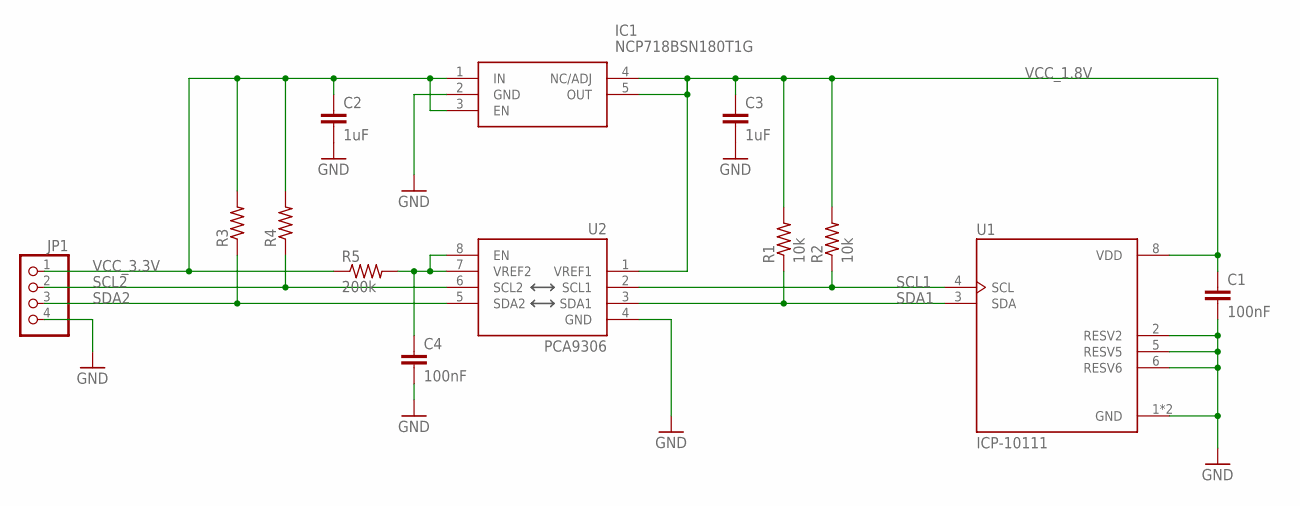
[picture p47: schematic altimeter.sch]

Parts:
C1, C4: 100nF; C0402
C2, C3: 1uF; C0402
IC1: NCP718BSN180T1G; SOT95P280X100-5N
JP1: PINHD-1X4; 1X04
R1, R2: 10k; R0402
R3, R4: R-US_R0402; R0402
R5: 200k; R0402
U1: ICP-10111; PSON65P250X200X100-8N
U2: PCA9306; PCA9306DC

Connections:
GND: C1.2, C2.2, C3.2, C4.2, IC1.2 (GND), JP1.4, U1.1 (GND), U1.2 (RESV2), U1.5 (RESV5), U1.6 (RESV6), U1.7 (GND), U2.4 (GND)
unnamed: C4.1, R5.2, U2.7 (VREF2), U2.8 (EN)
SCL1: R2.1, U1.4 (SCL), U2.2 (SCL1)
SCL2: JP1.2, R4.1, U2.6 (SCL2)
SDA1: R1.1, U1.3 (SDA), U2.3 (SDA1)
SDA2: JP1.3, R3.1, U2.5 (SDA2)
VCC_1.8V: C1.1, C3.1, IC1.4 (NC/ADJ), IC1.5 (OUT), R1.2, R2.2, U1.8 (VDD), U2.1 (VREF1)
VCC_3.3V: C2.1, IC1.1 (IN), IC1.3 (EN), JP1.1, R3.2, R4.2, R5.1

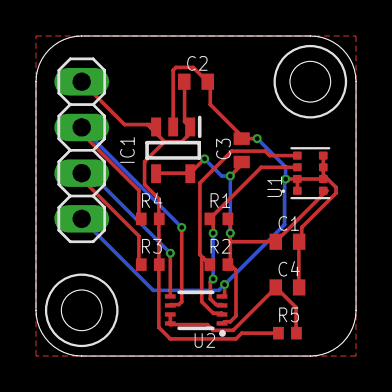
[picture p48: board altimeter.brd from above]

Board: 2 copper layers, 17.8 x 17.8 mm, 15 parts (0 on the bottom side), 8 nets.

Other parts of the board:
U$1, U$2: #2
