gisellegk/ECEN2440-final-project/PCB/MSP432 Board/MSP-EXP432P401R_EagleCAD.brd

## EAGLE design PCB/MSP432 Board/MSP-EXP432P401R_EagleCAD.brd (2019-11-17)

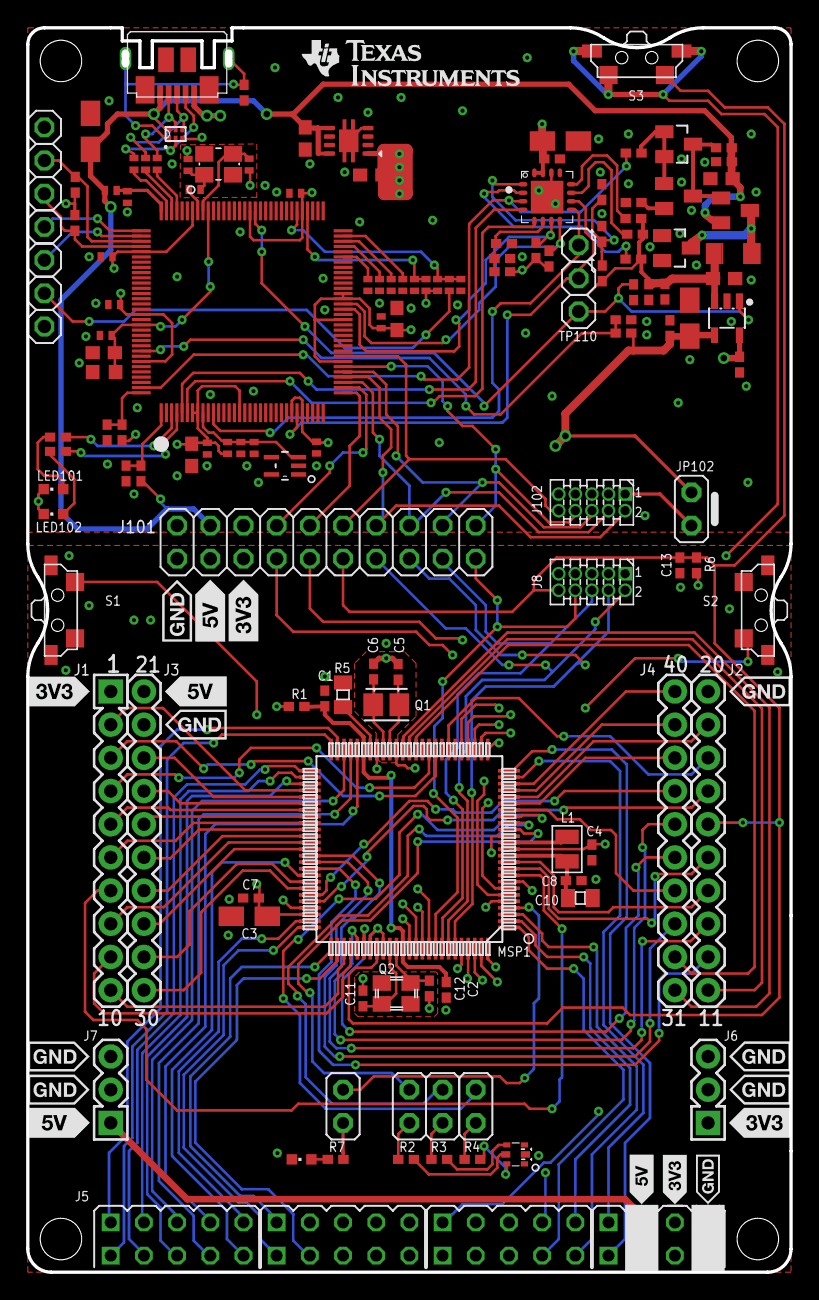
[picture p49: board MSP-EXP432P401R_EagleCAD.brd from above]

Board: 4 copper layers, 58.4 x 95.2 mm, 150 parts (0 on the bottom side), 160 nets.

Parts:
C1, C2, C4, C7, C8, C118, C120, C124, C129: 100n; 0402
C3: 10u; A/3216-18R
C5, C6, C11, C12: 22p; 0402
C10: 4u7; CSMD0805
C13: 1n; 0402
C101, C102: 12pF; C0402
C103, C131, C150: 0.1uF; C0402
C104, C110, C112, C114, C123: 10n; C0402
C105: 2u2; C0603
C106, C140: 4.7u; A/3216-18R
C107, C130, C132, C141: 1u; C0603
C108: DNP; C0402
C111, C113, C121: 100n; C0402
C115, C116: 33p; 0402
C117, C119: 4.7u; C0603
C126, C127: 220n; 0402
C128: 47u; A/3216-18R
C133: 2.2uF; C0603K
D101, D102: BAS40-05; SOT23
IC101: TPS73533DRB; SON8
IC102: TPD4E004_DRY_6; DRY6
IC103: TPS2102DBV; SOT23-5
IC106: TM4C129ENCPDT; TQFP-128
IC107: LM4040B25_DCK_5; DCK5
J1: J1
J2: J2
J3: J3
J4: J4
J5: EDGE_CON; BOTTOM_CONNECTOR
J6: HEADER 1X03; 3PIN_PWR_3V3
J7: BP_HEADERS_PWR_5V; 3PIN_PWR_5V
J8, J102: ARM-10
J101: J101_432
JP8: LED1; JP1M
JP9: LED2_RED; JP1M
JP10: LED2_GREEN; JP1M
JP11: LED2_BLUE; JP1M
JP102: JP1M
L1: 4.7uH; 0806
L101: 2u2; L3216C
LED1, LED101, LED102: CHIPLED_0603
LED2: EVERLIGHT_19-337; RGB_LED
MSP1: MSP432; PZ100
MSP101: MSP430G2452IRSA16R; RSA16
Q1: LF_XTAL
Q2: FA-238
Q101: NX3225GA_OSC; NX3225GA
R1: 0R; 0402
R2: 110R; 0402
R3: 16R; 0402
R4: 24R; 0402
R5: 91kOhm, 0.1%, 25ppm/C; 0805
R6, R107: 47k; 0402
R7, R111, R120, R124: 470; 0402
R101, R134: DNP; 0402
R102: 100; R0402
R103: 10k; R0402
R104, R140: 51; R0402
R105: 1k 1%; R0402
R106: 2R; R0402
R108, R109, R110: 1k; R0402
R112, R113, R114, R115, R133, R135, R136: 220k; 0402
R116, R117: 4k7; 0402
R118: 820; 0402
R119: 0; 0402
R123: 33; 0402
R125, R129: 10k; 0402
R126: 2k2; 0402
R127: 3k3; 0402
R128: 6k8; 0402
R131, R137, R138: 0; R0402
R132: 330k; 0402
R139: dnp; R0402
S1, S2, S3: TS-1188E
T101: DMG1013UW; SOT23
T102: BC850CW-115; SOT23-BEC
TP101, TP102, TP103, TP104, TP105, TP106, TP107, TP108, TP109, TP110: TEST_PIN2; 1X01
U$1, U$2, U$3, U$5: MOUNTHOLE_125MIL
U$4: LOGO16_TPLACE
U$7: MIKE_TM
U$8: P401R_REARSILK_REV2_1
U$9: REAR_TILOGO
U$10: COMPLIANCE_SUITESYMBOLONLY; EVM_COMPLIANCESUITE_SYMBOLONLY
U$11: COMPLIANCE_FCC_TEXTREAR; COMPLIANCE_FCC_TEXT
U$12: LOGO-ROCKET
U$13: P401R_SILKLABEL; SILKLABELUPDATED
USB101: MOLEX_105164-0001

Connections:
!RST: C13.1, J2.16, J8.10, J101.11, MSP1.83, R6.1, S3.S1
+3V3: C3.+, C4.1, C7.1, J1.1, J5.35, J5.36, J6.1, J8.1, J101.5, MSP1.13, MSP1.73, R1.1, R6.2
+5V: J3.21, J5.33, J5.34, J7.1, J101.3
AVCC: C116.2, MSP101.6, R114.2, R115.1
AVCCOUT: C115.2, MSP101.1, R112.2, R113.1
DCDCCAL0: MSP101.12, R126.2
DCDCCAL1: MSP101.2, R127.2
DCDCCAL2: MSP101.11, R128.2
DCDCIO0: IC106.P$5, MSP101.4
DCDCIO1: IC106.P$6, MSP101.5
DCDCPULSE: IC106.P$127, MSP101.3, R118.2
DCDCRST: IC106.P$11, MSP101.9, TP108.1
DCDCTEST: IC106.P$27, MSP101.10, TP109.1
DCOR: MSP1.44, R5.1
HOSTSCL: IC106.P$49, MSP101.7, R117.2
HOSTSDA: IC106.P$50, MSP101.8, R116.2
IRSTN: R102.1, TP106.1
ITCK: IC106.P$100, R129.1, TP103.1
ITDI: IC106.P$98, TP105.1
ITDO: IC106.P$97, TP104.1
ITMS: IC106.P$99, R125.1, TP102.1
LED0: IC106.P$3, R111.1
LED1: IC106.P$4, R124.1
unnamed: J102.1, JP102.2
unnamed: IC106.P$63, R108.2
unnamed: LED102.A, R124.2
unnamed: C1.1, C2.1, MSP1.45, MSP1.87, R1.2
unnamed: LED101.A, R111.2
unnamed: JP9.2, R2.1
unnamed: LED2.5, R2.2
unnamed: LED2.6, R3.2
unnamed: LED2.4, R4.2
unnamed: R119.1, T102.E
unnamed: D101.1, D101.2, R118.1, T102.B
unnamed: D102.3, L101.1, T101.3
unnamed: D101.3, R120.2, T101.1, T102.C
unnamed: LED1.A, R7.2
unnamed: JP10.2, R3.1
unnamed: IC106.P$93, R138.2
unnamed: IC106.P$61, R110.2
unnamed: IC106.P$95, R131.2
unnamed: JP11.2, R4.1
unnamed: IC106.P$62, R109.2
unnamed: JP8.2, R7.1
unnamed: C6.1, MSP1.42, Q1.1
unnamed: C5.1, MSP1.41, Q1.2
unnamed: IC106.P$59, R139.2
OSC0: C102.1, IC106.P$88, Q101.3
OSC1: IC106.P$89, R106.2
OSC1_R: C101.1, Q101.1, R106.1
P1.0_LED1: JP8.1, MSP1.4
P1.1_BUTTON1: MSP1.5, S1.S1
P1.2_BCLUART_RXD: J101.7, MSP1.6
P1.3_BCLUART_TXD: J101.9, MSP1.7
P1.4_BUTTON2: MSP1.8, S2.S1
P1.5_SPICLK_J1.7: J1.7, MSP1.9
P1.6_SPIMOSI_J2.15: J2.15, MSP1.10
P1.7_SPIMISO_J2.14: J2.14, MSP1.11
P2.0_RGBLED_RED: JP9.1, MSP1.16
P2.1_RGBLED_GREEN: JP10.1, MSP1.17
P2.2_RGBLED_BLUE: JP11.1, MSP1.18
P2.3_IO_J4.34: J4.34, MSP1.19
P2.4_PWM_J4.38: J4.38, MSP1.20
P2.5_PWM_J2.19: J2.19, MSP1.21
P2.6_PWM_J4.39: J4.39, MSP1.22
P2.7_PWM_J4.40: J4.40, MSP1.23
P3.0_IO_J2.18: J2.18, MSP1.32
P3.2_URXD_J1.3: J1.3, MSP1.34
P3.3_UTXD_J1.4: J1.4, MSP1.35
P3.5_IO_J4.32: J4.32, MSP1.37
P3.6_IO_J2.11: J2.11, MSP1.38
P3.7_IO_J4.31: J4.31, MSP1.39
P4.0_A13_J3.24: J3.24, MSP1.56
P4.1_IO_J1.5: J1.5, MSP1.57
P4.2_A11_J3.25: J3.25, MSP1.58
P4.3_A10_J1.6: J1.6, MSP1.59
P4.4_A9_J3.26: J3.26, MSP1.60
P4.5_A8_J3.27: J3.27, MSP1.61
P4.6_IO_J1.8: J1.8, MSP1.62
P4.7_A6_J3.28: J3.28, MSP1.63
P5.0_IO_J2.13: J2.13, MSP1.64
P5.1_IO_J4.33: J4.33, MSP1.65
P5.2/XT2IN: C12.1, MSP1.86, Q2.1
P5.2_IO_J2.12: J2.12, MSP1.66
P5.3: J5.9, MSP1.67
P5.3/XT2OUT: C11.1, MSP1.85, Q2.3
P5.4_IO_J3.29: J3.29, MSP1.68
P5.5_IO_J3.30: J3.30, MSP1.69
P5.6_PWM_J4.37: J4.37, MSP1.70
P5.7_IO_J2.17: J2.17, MSP1.71
P6.0_A15_J1.2: J1.2, MSP1.54
P6.1_A14_J3.23: J3.23, MSP1.55
P6.2: J5.12, MSP1.76
P6.3: J5.13, MSP1.77
P6.4_I2CSDA_J1.10: J1.10, MSP1.78
P6.5_I2CSCL_J1.9: J1.9, MSP1.79
P6.6_CAPTURE_J4.36: J4.36, MSP1.80
P6.7_CAPTURE_J4.35: J4.35, MSP1.81
P7.0: J5.17, MSP1.88
P7.1: J5.16, MSP1.89
P7.2: J5.15, MSP1.90
P7.3: J5.14, MSP1.91
P7.4: J5.24, MSP1.26
P7.5: J5.23, MSP1.27
P7.6: J5.26, MSP1.28
P7.7: J5.25, MSP1.29
P8.0: J5.22, MSP1.30
P8.2: J5.8, MSP1.46
P8.3: J5.7, MSP1.47
P8.4: J5.6, MSP1.48
P8.5: J5.2, MSP1.49
P8.6: J5.1, MSP1.50
P8.7: J5.3, MSP1.51
P9.0: J5.4, MSP1.52
P9.1: J5.5, MSP1.53
P9.2: J5.10, MSP1.74
P9.3: J5.11, MSP1.75
P9.4: J5.18, MSP1.96
P9.5: J5.19, MSP1.97
P9.6: J5.20, MSP1.98
P9.7: J5.21, MSP1.99
P10.0: J5.28, MSP1.100
P10.1: J5.27, MSP1.1
P10.2: J5.30, MSP1.2
P10.3: J5.29, MSP1.3
P10.4: J5.32, MSP1.24
P10.5: J5.31, MSP1.25
P96VBUS: C150.1, IC106.P$96, R140.2
REF_MAIN_LDO: IC106.P$128, R135.2, R136.2
REF_TARGET_VCC: IC106.P$120, R101.2, R134.2
TCK_SWDCLK: J8.4, J101.15, MSP1.95
TDI: J8.8, J101.19, MSP1.92
TDO_SWO: J8.6, J101.17, MSP1.93
TMS_SWDIO: J8.2, J101.13, MSP1.94
VBUS_DETECT: IC106.P$1, R132.2, R133.2
VCCEN1: IC103.1, IC106.P$78, R107.1, TP110.1
VCORE: C8.1, C10.1, L1.1, MSP1.12
VDDC: C131.1, C132.2, C133.1, IC106.P$87, IC106.P$115
VREFA+: C110.1, C111.1, IC106.P$9, IC107.3, R105.1
VSW: L1.2, MSP1.14
XDS-GND: C1.2, C2.2, C3.-, C4.2, C5.2, C6.2, C7.2, C8.2, C10.2, C11.2, C12.2, C13.2, J2.20, J3.22, J5.37, J5.38, J6.2, J6.3, J7.2, J7.3, J8.3, J8.5, J8.7, J8.9, J101.1, LED1.C, LED2.1, LED2.2, LED2.3, MSP1.15, MSP1.40, MSP1.43, MSP1.72, MSP1.82, MSP1.84, R5.2, S1.G1, S1.G2, S1.S2, S2.G1, S2.G2, S2.S2, S3.G1, S3.G2, S3.S2
XDSET_!RST: C108.1, IC106.P$70, R102.2, R103.2
XDSET_DM: IC102.5, R138.1, USB101.D-
XDSET_DP: IC102.4, R137.1, USB101.D+
XDSET_DPR: IC106.P$94, R137.2
XDSET_GND: C101.2, C102.2, C103.2, C104.2, C105.2, C106.-, C107.2, C108.2, C110.2, C111.2, C112.2, C113.2, C114.2, C115.1, C116.1, C117.2, C118.2, C119.2, C120.2, C121.2, C123.2, C124.2, C126.2, C127.2, C128.-, C129.2, C130.1, C131.2, C132.1, C133.2, C140.-, C141.2, C150.2, D102.1, D102.2, IC101.4, IC101.9, IC102.3, IC103.2, IC106.P$10, IC106.P$17, IC106.P$48, IC106.P$55, IC106.P$58, IC106.P$64, IC106.P$66, IC106.P$80, IC106.P$114, IC107.1, J101.2, J102.3, J102.5, J102.7, J102.9, LED101.C, LED102.C, MSP101.13, MSP101.14, MSP101.TP, R101.1, R107.2, R108.1, R109.1, R110.1, R113.2, R115.2, R119.2, R123.2, R133.1, R136.1, R139.1, TP101.1, USB101.GND
XDSET_ID: IC102.2, R131.1, USB101.ID
XDSET_RESET_OUT: IC106.P$40, J101.12, J102.10
XDSET_RXD: IC106.P$33, J101.10
XDSET_SHIELD: IC102.1, R123.1, USB101.SHIELD_TH1, USB101.SHIELD_TH2
XDSET_TCK_SWDCLK: IC106.P$35, J101.16, J102.4
XDSET_TDI: IC106.P$38, J101.20, J102.8
XDSET_TDO_SWO: IC106.P$37, J101.18, J102.6
XDSET_TMS_SWDIO: IC106.P$36, J101.14, J102.2
XDSET_TXD: IC106.P$34, J101.8
XDSET_VBAT: C103.1, IC106.P$68, R104.2
XDSET_VBUS: C117.1, C118.1, C140.+, C141.1, IC101.5, IC101.8, IC102.6, J101.4, R120.1, R132.1, R140.1, T101.2, USB101.VBUS
XDSET_VCC: C104.1, C105.1, C106.+, C107.1, C112.1, C113.1, C114.1, C121.1, C123.1, C124.1, C126.1, C130.2, IC101.1, IC103.5, IC106.P$7, IC106.P$8, IC106.P$16, IC106.P$26, IC106.P$28, IC106.P$39, IC106.P$47, IC106.P$51, IC106.P$52, IC106.P$69, IC106.P$79, IC106.P$90, IC106.P$101, IC106.P$113, IC106.P$122, MSP101.15, MSP101.16, R103.1, R104.1, R105.2, R114.1, R116.1, R117.1, R125.2, R129.2, R135.1, TP107.1
XDSET_VCCOUT: C119.1, C120.1, C127.1, IC103.3, L101.2, R112.1, R126.1, R127.1, R128.1
XDSET_VCCTARGET: C128.+, C129.1, IC103.4, J101.6, JP102.1, R134.1
