gisellegk/ECEN2440-final-project/(commit log)

2019-11-11 Add PCB stuff with components and a couple wiring traces
    [Custom Sheild-PCB.sch]
2019-11-11 add altimeter board
    [altimeter.brd, altimeter.sch]
2019-11-11 Created library and made altimeter
    [Custom Sheild-PCB.sch]
2019-11-12 Made MSP432 and fixed other components
    [Custom Sheild-PCB.sch, MSP-EXP432P401R_EagleCAD.brd]
2019-11-13 Added the radio device, and made a couple connections
    [Custom Sheild-PCB.sch]
2019-11-13 Fixed the DRA818 and started connecting traces
    [Custom Sheild-PCB.brd]
2019-11-13 made a couple connections
    [Custom Sheild-PCB.brd, Custom Sheild-PCB.sch]
2019-11-14 Connected Pins
    [Custom Sheild-PCB.sch]
2019-11-14 add teensy lib
2019-11-14 PDR schematic and board
    [Custom Sheild-PCB.brd, Custom Sheild-PCB.sch]
2019-11-14 Final board and schematic
    [Custom Sheild-PCB.brd, Custom Sheild-PCB.sch]
2019-11-15 Made updates to board and created now radio breakout board
    [Custom Sheild-PCB.brd, Custom Sheild-PCB.sch, Radio Board.brd, Radio Board.sch]
2019-11-17 add some new ltpsice models
    [1.3V test schematic.sch, 5.0v test schematic.sch]
2019-11-17 add pcb way quote image
2019-11-17 lt spice stuff
    [1.3V test schematic.sch, 5.0v test schematic.sch]
2019-11-18 add preliminary teensy UART stuff
    [datalog.csv]
2019-11-18 add uart WIP stuff from lab folder
2019-11-18 minor changes to board
    [Custom Sheild-PCB.brd, Custom Sheild-PCB.sch, Radio Board.brd, Radio Board.sch]
2019-11-18 move teensy code into code dir
    [datalog.csv]
2019-11-18 New changes to pcb board
    [Custom Sheild-PCB.brd, Custom Sheild-PCB.sch]
2019-11-18 Final updates to the board
    [Custom Sheild-PCB.brd, Radio Board.brd, Radio Board.sch]
2019-11-19 radio board routing
    [Radio Board.brd, Radio Board.sch]
2019-11-19 PWM Code and Computations
2019-11-19 final (before review & order) dra818v breakout board
    [Radio Board.brd, Radio Board.sch]
2019-11-19 prettyfy schematic. vague shield board layout.
    [Custom Sheild-PCB.brd, Custom Sheild-PCB.sch]
2019-11-19 I2C Code for Altimeter
2019-11-20 Changes to board of sheild
    [Custom Sheild-PCB.brd]
2019-11-20 changes to the sheild board
    [Custom Sheild-PCB.brd]
2019-11-20 changes to the traces of the shield board
    [Custom Sheild-PCB.brd, Custom Sheild-PCB.sch]
2019-11-20 changes to the traces of the sheild board
    [Custom Sheild-PCB.brd, Custom Sheild-PCB.sch]
2019-11-20 changes to traces on sheild board
    [Custom Sheild-PCB.brd]
2019-11-22 Created PWM code and did stuff with code
    [Custom Sheild-PCB.brd]
2019-11-22 SPICE models everywhere
    [1.3V test schematic.sch, 5.0v test schematic.sch, BD00C0AW.OLB, BD33C0AW.OLB, PUPPYSPICE.DSN, puppyspice.opj]
2019-11-23 final (i hope) radio board
    [Radio Board.brd, Radio Board.sch]
2019-11-24 final board maybe??
    [Custom Sheild-PCB.brd, Custom Sheild-PCB.sch, Radio Board.brd, Radio Board.sch]
2019-11-24 pspice is terrible
    [NCP1117 MODEL LIBRARY.OLB, NCP1117 MODEL LIBRARY.OPJ, puppyspice.opj]
2019-11-24 add voltage test points
    [Custom Sheild-PCB.brd, Custom Sheild-PCB.sch]
2019-11-24 Fix MSP432 footprint
    [Custom Sheild-PCB.brd, Custom Sheild-PCB.sch]
2019-11-25 really important commit
    [Custom Sheild-PCB.brd, Custom Sheild-PCB.sch, Radio Board.brd, Radio Board.sch, meowth.brd, meowth.sch]
2019-11-27 UART echoing works
2019-11-27 successfully prints garbage (i mean, randomly generated letters) over UART.
2019-11-27 teensy uart tested and works
2019-11-27 it does a thing
    [msp-teensy-3-byte.csv, teensy-teensy_basic_uart.csv]
2019-11-29 worked on PWM code
2019-11-29 Housing for the Rocket
    [Prototype 1 assembly.SLDASM, Prototype 1.SLDPRT, prototype 1b.SLDPRT]
2019-11-29 Changes to housing
    [Prototype 1 assembly.SLDASM, Prototype 1.SLDPRT, prototype 1b.SLDPRT]
2019-11-29 worked on pwm code, still errors on float type
    [main.c]
2019-11-30 I2C and PWM
2019-11-30 Global Variable PWM Change
2019-11-30 code PWM
2019-12-01 update pspice files
    [BD00C0AWFP.DSN, BD00C0AWFP.opj, BDxxC0AxFP.OLB, NCP1117 MODEL LIBRARY.OPJ, PUPPYSPICE.DSN, bdxxc0axfp.opj, puppyspice.opj]
2019-12-01 final board stuff
    [Custom Sheild-PCB.brd, Custom Sheild-PCB.sch, Radio Board.brd, Radio Board.sch]
2019-12-01 PWM: add while(1) loop, modulus for the array, fix indentation?
    [main.c]
2019-12-02 uart SD logging + altimeter
    [altitude_log_12_2.csv]
2019-12-03 Update morse code and teensy
2019-12-03 Teensy acknowledge
2019-12-04 Changes to the Housing
    [Designed for tube prototype 2.SLDPRT, Designed for tube prototype 2b.SLDPRT, Prototype assembly.SLDASM]
2019-12-04 teensy sd + alt
2019-12-04 STL files
    [Designed for tube prototype 2.SLDPRT, Designed for tube prototype 2.STL, Designed for tube prototype 2b.SLDPRT, Designed for tube prototype 2b.STL]
2019-12-05 Calibration Code
2019-12-05 uart + alt
2019-12-06 why is uart being weird
    [integrated_623p_12_5_19.csv]
2019-12-06 Cap housing
    [CAP for Prototype 2 THIS ONE.STL, Designed for tube prototype 2b.SLDPRT, Designed for tube prototype 2b.STL]
2019-12-06 Cap changes housing
    [CAP for Prototype 2 THIS ONE.STL, Designed for tube prototype 2b CAP THIS ONE.STL]
2019-12-07 CAP changes
    [Designed for tube prototype 2b CAP THIS ONE.STL]
2019-12-07 teensy hack fix
    [crcs_check_out_917p_12_6_19.csv]
2019-12-07 better teensy uart hack
2019-12-07 add new file code. for some reason correct indexing broke
    [correct_indexing_1203a_12_7_19.csv]
