gisellegk/ECEN2440-final-project/(notices)

Notices in the files:
PCB/MSP432 Board/MSP-EXP432P401R_EagleCAD.brd:
(C)2003 A. DANNENBERG
parts and their libraries:
SparkFun-Resistors: Licensing: Creative Commons ShareAlike 4.0 International - https://creativecommons.org/licenses/by-sa/4.0
